tel/4601/final/final.tex

\documentclass{article}
\usepackage{../tex/mysty}
\begin{document}

\maketitlepage{Final Report}{Shuyen Liu}

\setcounter{tocdepth}{3}
\tableofcontents
\newpage

\section*{Executive summary}
\label{sec:exec-summary}

Modern research suggests that genetics is closely related to ophthalmological diseases such as 
myopia, a trend that can be studied by examining alterations in gross eye shape. Currently research is performed using mouse models which are easily available, genetically altered, and affordable. Due to the small size of mouse eyes, such research calls for high-resolution devices capable of measuring the dimensions of an object on a very small scale. This project proposes a 3D imaging device capable of 
measuring eye shape with micrometer precision. The target users of the device are primarily ophthalmological researchers studying genetics, but the application of the device may be extended to any field that requires 3D imaging of small object. 
The client of the project, Dr. John Nickerson of Emory University, requested that the final solution be able to produce a reconstructed 3D image of a mouse eye ball down to the resolution of 2 $\mu$m given a non-deformed eyeball with no concavities. The client also provided a Keyence LS-7030 LED digital micrometer as the  device’s core component. Device design centers on the provided micrometer, which utilizes parallel visible light beams in a concept  similar to early CT
designs. Thus, the design of the imaging device resembles that of earlier CTs. Theoretically, 
the device will rotate the object and measure each slice, and once finished will move to the 
next slice. The image will be reconstructed through back projection of the 
measurements of each slice and subsequent stacking of all the reconstructed slices. To achieve 
the tasks, the design solution uses motors to rotate the eyeball, which is fixed in a 
harness and polymer solution-filled tube, and to drive the micrometer, connected to a designed block, up and down shafts in order to create image slices. The solution also includes National Instruments LanVIEW software and hardware that control the device and perform image reconstruction of the eye.

Performance testing occurred throughout the process of prototype development to 
verify if each version of component satisfied certain criteria. Tests were done in a binary pass/fail fashion due to time constraints and divided into three categories: physical, electrical, and computer or programming. Initial prototype iterations had major failures related to misalignment of the physical components that resulted in skewed measurement data. The latest prototype did not fail any tests.

The envisioned final device will a structural framework similar to the prototype, but its mechanical and electrical components will be placed in a metal casing so that the user will be interacting with a black box and its controlling software rather than being exposed to several messy circuits. The eyeball will also be held in an optical tube, and an optical lens will be purchased to correct for the distorted measurement caused by the polymer fixate. Recommendations for design improvement include replacement of motors to those with encoders to increase accuracy, more precise manufacture of components to improve alignment, and a redesign of the optical lens/tube/polymer system to avoid bending the path of light from the micrometer. After implementing these suggestions, the final 
solution will fulfill the major requirement that 3D image resolution should be at micron 
level. 

\newpage

\section{Project Description}
\label{sec:project-description}

\subsection{background}
\label{sec:background}
Myopia is one of the most common ocular diseases in human, reaching approximately 25\% of most Western population and more than 80\% in some Asian populations.\cite{rajan98}1 Current research suggests that there is a strong genetic influence upon the development of the condition in addition to extrinsic factors.\cite{zhou99:genes,zhou99:models,schmucker04}2,3,4 As a result of such studies, many ophthalmology researchers have begun to focus on how specific genes affect the development and maintenance of the eye. Mouse has been commonly used as an animal model due to availability, ease of genetic manipulation, and affordability.\cite{schaeffel04}ref 8  However, because precise measurements of the eye dimensions are essential in determining the effect of genes and environmental factors on eye growth and disease, the small size of the mouse eye has been a critical impediment to research in this field.\cite{schaeffel04}ref5 
 
Using the mouse model, researchers need to be able to accurately measure the Anterior-Posterior axis of the small mouse eyeball, whose effective anatomical deformations occur at resolutions of 5 microns.\cite{schaeffel04}ref5  Current techniques for characterizing external eye shape (Table 1 of 4600 final) include manual contact (physical micrometry),\cite{wallman04} ref6 histological sectioning,\cite{schaeffel04}ref5 magnetic resonance imaging (MRI), computed tomography (CT) imaging, positron emission tomography (PET) imaging,\cite{atchison04}ref7 and optical interferometry.\cite{schaeffel04,guggenheim04}ref5,8 Each technique measures the eye but is either too difficult for common use or too inaccurate for precise use. Presently, no method exists for rapidly, easily, and accurately determining the gross exterior shape of the eye at a resolution under 5 μm within a laboratory setting. 

\subsection{Target Device}
\label{sec:target-device}
One current technique for determining eye shape involves manual measurement of the eye dimensions on the micrometer level using a high-precision, high-throughput industrial laser-emitting diode (LED) micrometer. \cite{Nickerson}ref9 (SIA) While other technical methods involve complex optical manipulations, automated measurement and manipulation of an LED micrometer could fill the oft-cited need for a lab bench-sized, automated digitizer which can handle small organic objects such as dissected mouse eyes.\cite{schaeffel04,atchison04,zhou99:genes,zhou99:models} ref8,1,2,3 of project update  The ideal design involves a high-precision articulation frame which locates and manipulates the
measurement plane of an attached micrometer in order to scan over the full geometry of the eye. Collected scanning data is then sent to a computer controller for decoding and used for construction of a digital, three-dimensional (3D) model of the scanned object. Such a device could quickly, precisely, and repeatedly provide the full gross geometric shape of a dissected eye and also provide for software to statistically analyze trends in shape over populations and experimental treatments.

The team has proposed a device which implements complete 3D reconstruction of the eye by scanning over the eye with a laser-emitting diode (LED) micrometer. The device, pictured in FIGUREONE(SIA), consists roughly of three parts including an eye-actuating harness, the micrometer frame, and
the computer interface. The eye harness holds the eye and fixes it rigidly for acceleration without impacting the optical path for the micrometer. It consists of a pair of reverse-action tweezers which are fitted into a cylindrical cuvette filled with a high-viscosity polydimethylsiloxane (PDMS) buffer suspension. When the cuvette is inserted into the frame of the device, it is placed against a corrective lens which corrects for the optical distortion from the cylinder (not shown). The harness then attaches to a motor supplemented by an angular encoder, which can then accelerate the tube while simultaneously keeping high-resolution data on its current theta-position (PICTURES/ADDENDUMS/LABELING OF PARTS?).

The micrometer frame holds the motors and the micrometer heads, which consist of the receiver and transmitter. The heads are attached to a syringe pump frame augmented with another motor/encoder pair to provide linear articulation in the z-direction while maintaining high-resolution position data. Finally, the data from the two encoders and the micrometer is fed into a National Instruments Single-board Reconfigurable Input Output device (sbRIO), which provides real-time feedback and control while collecting data for online reconstruction (PICTURES/ADDENDUMS??). The reconstruction algorithm itself is a modified back-projection algorithm supplemented by cosine interpolation in the z-direction (PICTURES/ADDENDUMS).

\subsection{Target Users and Societal Impact}
\label{sec:users}
The target users of the device will be researchers in ophthalmology, particularly those who conduct studies requiring precise measurements of an eye. An estimated number of 500 researchers working at 70 medical research institutions will benefit from the device\cite{Nickerson}ref9 (SIA), which  will enable researchers to conduct current research easier and faster and introduce new avenues such as scanning techniques through which to study the eye. The improved performance supplied by the device would translate into savings, in terms of both time and money, for both researchers and organizations
that fund them, such as the National Institutes of Health (NIH). This in turn would allow money from the
general public and resources at research institutions to be invested in making discoveries on more fronts,
advancing scientific knowledge at a greater rate. %apparently we want to quantify this last bit how does this make sense?

\section{Engineering Design Specifications (EDS)}
\label{sec:engin-design-spec}
A complete list of engineering design specifications is shown in Table ONE \ref{tab:eds}.

\subsection{Functional and Customer Requirements}
\label:{sec:func-cust-req}
The customer requirements can be split into three categories: needs, wants, and desires. ``Needs'' are the functional requirements and constitute essential aspects of the device required for proper use, while ``wants'' are non‐essential aspects of the device that would facilitate proper use. ``Desires'' are aspects of the device which, if satisfied, would please the customer beyond proper functioning.  

The most significant feature needed by the device is the ability to take automated measurements of ocular dimensions with a resolution of 0.5 diopters, equivalent to a resolution of 2 $\mu$m for mouse eyes. The critical active sensing components of the device need to have a resolution below 2 $\mu$m in order to ensure precise
measurements at a resolution of 2 $\mu$m. The device also needs to be
able to convert raw measurements into a 3D interactive reconstruction
of the eyeball on a computer interface. The client initially requested that
the device be able to take a complete set of measurements in
under 3 minutes in order to prevent the eye from drying out and
distorting the results, but given the addition of a polymer fixate to the design, the time requirement was dropped. Also, the device needs to be able to fit onto
a typical laboratory bench, into a space of 1m $\times$ 1m $\times$
1m, but does not need to maintain a sterile field.

One ``want'' of the client is that the device has mobility; that is,
it can be lifted and carried from one lab bench to another by an
average healthy researcher from age 20‐50. Therefore, the device
should be lightweight; the weight of the device should not exceed 40
lbs (18 kg).\cite{gross03} To fulfill the mobility want, the size of
the device must also be small. The device must
be able to fit on a typical laboratory bench, in a space of 1m $\times$ 1m $\times$ 1m. The device should also not be cumbersome; the design of the device should be
simple and manageable with few external components.

The customer also wants the device to have a simple user interface with which measurements taken by the device may be transferred onto a connected computer with just 1 click of the mouse. The device should  be reusable for up to 4 years given constant daily use of the device at least 5 times a day, with 1 hour per use.\cite{keyence01} The device should not require any maintenance unless one of the components stops functioning.\cite{keyence01} In addition, the device should cause little to no vibration during operation such that the accuracy of measurements is unaffected. 

Finally, the client desires that the device be aesthetically pleasing, and not make much noise during operation. The noise produced by the device should not exceed the level of 80 dB, the loudness of the average car.\cite{truax09}

\subsection{Engineering Characteristics}
\label{sec:eng-char}
The device needs to be robust enough to withstand the stresses of
everyday lab use. Robustness is defined as the ability to withstand
rough accidental movement such as being dropped from the top of a lab
bench, typically at a height of 3 feet, or shoved sideways on the
bench surface. The device should also be able to hold the weight of
small objects no heavier than 5 pounds, such as lab notebooks, pens,
or a rack of test tubes. The device needs to be able to function in
the wide range of temperatures typically found in the laboratory (22±5
$^\circ$C) and, as mentioned previously, it needs to be able to fit comfortably onto a lab bench withina space of 1m $\times$ 1m $\times$ 1m. The non‐electrical components
of the device should be inert and should not be affected by small
quantities (less than 1 mL) of minimally hazardous solutions such as
PBS,\cite{users_manual} which is typically used to keep the eye
moist. Electrically, the device needs to function with 120V 60Hz AC,
the standard power supply of the United States.

\section{Prototype Development Discussion}
\label{sec:prot-devel-disc}
 
The device design consisted of four main aspects. The frame, eye harness, electrical components, and computer interface were all developed separately. Each aspect of the device underwent several iterations. A prototype development timeline can be seen in TABLETWO-TO-BE-UPLOADED.

\subsection{Introduction}
\label{sec:prior-art}
	The central component of the device is the Keyence LS-7030 LED digital micrometer provided by 
the client. The LED micrometer assumes that light travels between the emitter and receiver in an 
undistorted fashion, and that only the measured object occludes some of the light incident upon the 
receiver, as reviewed in US patent No.6,947,152, High Speed Laser Micrometer.  A prior art and literature search found that among the current techniques, x-ray computed tomography is most relevant to the design solution of the current opportunity because its core measuring component is similar to the LS-7030 micrometer in concept. The principal steps in computed tomography 
include measuring attenuation at different angles, reconstructing a slice via back-projection, and repeat the step for next slice. The design solution was based on this process, which requires angular (theta) and 
translational (z) motion and image reconstruction. 

\subsection{Design Components}
\label{sec:prototype-comp}
	The design solution prototype employs two motors for angular and translational motion. The initial design focused on resolution of the resulting image and intended to move the micrometer both translationally and angularly. However, the team found that this design was hampered by a significant moment of inertia due to the weight of the micrometer. In addition, the client raised concerns about damaging the micrometer, the core piece of the device. 

Given these concerns, the team re-designed the device to rotate the target of interest (the mouse eyeball) and, at the same time, move the micrometer translationally. In accordance with these goals and the requirements of the EDS (TABLE ONE), the initial design solution consisted of the following components: 

\begin{enumerate}
 \item an optical tube with polymer fixate that suspends the mouse eyeball and helps it maintain its overall shape; 
\item a harness that holds that prevents the tube from moving translationally as it is being rotated and holds the tweezers that suspend the eyeball in the center of the tube;
\item motors for rotational (theta) and translational (z-axis) motion; 
\item connecting shafts between the rotational (theta) motor and the cylindrical tube and between the translational (z-axis) motor and the micrometer;
\item a structural framework to ensure physical alignment between components; 
\item encoders, in conjunction with a National Instruments sbRIO board, which manipulate the motors and transfer data between the motors to the computer;  
\item an image reconstruction algorithm created in the LabVIEW Development System;
\item and a user-centered computer interface. 
\end{enumerate}

\subsection{Harness and Fixate}
\label{sec:harness}
	The interior piece of the device consists of an optical tube bookended by two caps on the top and bottom (SOME KIND OF PICTURE REFERENCE SHUYEN’S SOLIDWORKS YAY).  The top cap has a slit through which tweezers will be placed in order to suspend the eyeball by the optic nerve, while the bottom cap is connected to the theta (rotational) motor through a shaft. The bottom cap is detachable from the theta-motor shaft so that the tube can be removed from the device and be loaded with a new eyeball. A polymer fixate inside the tube allows the eyeball to maintain its gross shape.  All of the core pieces are cylindrical and have their centers on the axis of rotation. An optical lens outside of the tube will correct the path of light from the micrometer that is distorted by the tube and fixate solution.
	
The development of the eye harness and its associated components can be seen in TABLE TWO TO BE UPLOADED. Initially, the eyeball was placed in a standard test tube and a 10\% methyl cellulose solution. However, the distortion of light caused by methyl cellulose was too great, and so the polymer fixate was switched to a 10:0.2 ratio of PDMS base and curing agent due to the optical and viscous properties of PDMS . The team then found that the optimal viscosity for the fixate was a 10:0.3 ratio of PDMS base and curing agent, and so used that solution as the final fixate. Finally, a custom-made cuvette was made in order for the tube to fit more neatly into the harness. The cuvette, however, was not made of optical glass, and an optical lens to correct for the distortion of the tube and polymer was never purchased due to temporal and financial constraints. 
	
The eye harness, tweezers, and connector pieces also each underwent several iterations (TABLE TWO TO BE UPLOADED). The harness and tweezers initially started off as big, bulky pieces whose size was narrowed down over the course of development. (REF, FIGURES HERE?)

\subsection{Framework}
\label{sec:frame}
	The device contains a structural framework that allows the axis of rotation of the theta motor, the eyeball, and the structures that support the eyeball to be along the same axis. The micrometer heads are attached by their base to a block whose position is guided and driven by the translational or z-motor through threaded shafts. The position of the micrometer is controlled in such a way that the plane of measurement is perpendicular to the axis of rotation (REF: PICS AND/OR SOLIDWORKS DRAWINGS). A computer connects to the motors to control them and reads data from the micrometer for image 
reconstruction. 
To achieve good alignment, the design solution uses custom-made pieces to hold components in place. A flat metal board is used as a base on which the mechanical components sit. A frame, consisting of a top, a bottom, and two legs that connect and support the top piece to the bottom piece, attaches to the heavy metal base with bolts and nuts. The theta-motor is press-fitted to sit in a designed cavity and defines the axis of rotation. The top piece has a hole that is concentric to the axis of rotation and serves to maintain alignment of the eye harness, eyeball, and fixate tube. 
	Like the eye harness, the framework narrowed in size with each iteration. Additionally, the framework parts and other custom-made pieces were initially constructed using a  Zprinter® 310 (inkjet) Printer with special starch powder, but were later printed using the Stratasys(Registered) Dimension 1200 FDM (Fused deposition modeling) Printer with ABS (acrylonitrile butadiene styrene) material. 

\subsection{Notable Iterations}
\label{sec:iterations}

The first draft of the prototype’s structural framework from the Zprinter showed that the structure was sturdy enough to not vibrate excessively when connected to the motor. However, since the Zprinter does not have good enough resolution for tight connections and precise positioning of parts, the FDM Printer was chosen to print the structures for later iterations. The second draft of the framework used the same blueprint as the initial draft but was printed with the FDM printer, resulting in a framework that is lighter, more precise, and allowed better fitting between parts. Like the z-printed model, it is also strong and does not vibrate much. 
	The first z-motor was was 0.6 amperes mounted on a modified microscope stage. It did not have enough power to drive the micrometer and was switched with a 2 ampere stepper motor on syringe pump.

\subsection{Electronics and Programming}
\label{sec:electronics}

The National Instruments sbRIO board, which runs using LabVIEW Real-Time and LabVIEW FPGA software on the computer, links the computer and the hardware and is used as a controller for the entire device (PIC#). The board collects all measurement data at an appropriate rate, and also inputs commands to both the rotational and translational motor, providing the user with real-time, deterministic control over the device. The protoboard (PIC#) converts inputs from the sbRIO board into outputs that drive the motors, while the host computer provides a user interface for control of the device in addition to logging trinary measurement data (from the z-axis, theta axis, and micrometer) and performing image reconstruction using such data. 

The team initially faced difficulty in recording binary code decimal (BCD) digits, the form of data given by the micrometer, and in collecting the data from the motors and micrometer in a real-time, simultaneous fashion required for accurate reconstruction. However, with each iteration (and each successive experiment with the LabVIEW software), the team became more familiar with the software and gradually de-bugged and polished the code to solve these problems. 

	Image reconstruction was performed using an online freeware program called MeshLab. \citeMESHLAB_CREATE CITATION, which used a combination of Poisson reconstruction and Ball-pivoting surface reconstruction to perform 3D reconstruction on the acquired data. 

The current version of the prototype can be seen in FIGURES  TWO THREE FOUR FIVE SIX (Joe’s pics from today, numbered and labeled with all parts)

\section{Performance Testing and Results}
\label{sec:perf-test-results}

Performance testing took place for each aspect of the device after every iteration and revision. Due to time constraints, all of the testing was done in a binary (pass/fail) fashion to see if the component met certain minimal requirements. The tests were broken down according to three major subsystems: physical/mechanical components, electrical components, and computer control tests. Under each system there were sub-subsystem such as the frame and eye harness for mechanical tests and the motors for the electrical tests. The testing hierarchy and details are listed in the TableTHREE (tests.csv). Tests were done on a case-by-case basis and did not correlate to those listed in the verification protocol since they required revision after each design iteration. 
	
Tables FOURFIVEANDSIX (tests-c.pdf, tests-e.pdf, and tests-p.pdf) contain the test results, showing whether each revision (as referenced in the TABLE TWO) achieved a certain requirement. Major physical failures generally pertained to the rotational theta motor and eye harness; an angle exists between the axis of rotation and the axis of the eye harness tube, causing the eyeball to shift in space and resulting in poor accuracy and precision for collected data and reconstruction. Other failures like the inability of the theta motor to resist heating and possible eye shape distortion over a two-hour time span set an upper limit for the data acquisition time. Electrically, the only significant failure was the inability to record binary code decimal (BCD) digits from the micrometer. Since BCDs are the form of data given by the micrometer, this failure initially limited the method applicable for image reconstruction. 

	For the computer  control aspect of testing, most of the failure occurred on the software side. The software was not able to control the motors and collect data in a real-time fashion. In addition, as the software controlled and recorded data, there were small time-delays between recordings of theta position, z position, and the length information from the micrometer.  This problem was solved during further design iterations that polished and optimized the code in the LabVIEW software. 

\section{Final Design Solution}
\label{sec:final-design-solut}

The final device will have a structural framework similar to the one found in the most recent prototype; this framework design is stable and strong enough to sustain moderate weight. The electronics will be compressed into printed circuit board, or PCB, to reduce volume, since the current prototyped bread board circuit is messy and not spatially efficient. The physical set-up of the device is demonstrated in Fig##(final schematic.jpg) .

The prototype, as seen in FIGURE-PIC, currently has all of its components exposed, leading to a risk of misalignment or other accidents like liquid reagent spills in the laboratory that affect device function.  For the final design solution, all of these components will be placed inside a metal enclosure designed to be the smallest size possible. The top of the structural framework with the tweezers slit will be at exposed to the outside environment through a small opening at the top of the enclosure, allowing the user to assemble the eye harness with inverted tweezers, an eyeball, and a tube of polymer fixate and insert it into the device. The PCBs will be attached to the bottom of the case - a role currently served in the prototype by the heavy metal base board (FIG SOLIDWORKS topdown_frame) -  and all wiring and connections will run along the wall of the case to a connection window that opens to the outside. The edges of the case will be rounded for safety considerations and made out of aluminum sheet of at least 0.1 inch thickness, ensuring that it is strong enough to sustain 40lbs of weight. Rubber feet will on the bottom corners of the box in order to prevent the box from sliding off of a table or damaging the surface on which it is placed. The case will also have ergonomic, padded handles with rubber grips to facilitate lifting and transportation of the case.  

The z-actuator (REF FIGURE final_schematic) will consist of the guiding rails, driving shaft, and the z-motor. The rails and shaft will essentially be the same as the ones used in the current prototype. However, a more highly powered z-motor with an attached encoder will replace the motor currently in use so that the micrometer will experience less vibration and the z-position can be more accurately determined. The theta motor will also be replaced for better driving power, accuracy and heat resistivity. Heat resistivity is of interest because thermal expansion can mess up the alignment and perhaps melt any plastic piece in immediate contact with the motor.

The eye harness pieces will also retain similar profiles to those of the prototype, consisting of a top and bottom cap, a polymer fixate solution within an optical tube, and inverted tweezers.  The final device will also contain an optical correction lens to account for the distortion of the polymer solution and the tube. The top cap of the harness will be designed to have a ratchet button attached to a pair of reverse tweezers whose tip opens up when the button is pressed, allowing the eyeball to be loaded more easily into the device. The harness requires high accuracy production so that all of its optical properties are correct and all of the components are accurately aligned. The fixate solution will also be custom manufactured so that its optical properties match the corrective lens.

The software and hardware of the final device will have the same functions as in the prototype. They will control the motors, gather data from the micrometer and motors, and reconstruct a 3D image using the collected data. 

The motors will drive the eyeball and the micrometer in the following fashion as seen in FIGURE SOMETHING. The theta-motor initializes and drives the eyeball at constant speed, and after each 
full rotation, the z-motor drives the micrometer to the next z-position for acquisition of a new image slice. These two steps repeat until the whole eyeball is scanned. The stopping condition will be two thresholds outside of data is no longer collected from the eyeball. The micrometer reading speed is set to ???, the theta motor speed is set to ???.

The user interface, currently not designed, will consist of a graphical user interface with buttons for starting the scan, emergency stop, image reconstruction and display and other minor functions. 

\section{Discussion, Conclusion, and Recommendations}
\label{sec:concl-recomm}

The final prototype meets some of the requirements of the EDS (TABLE ONE). It can acquire the desired measurement data and perform 3D reconstruction using such data, therefore it fulfills its main functionality. It is able to move both the object and the micrometer, and its structural framework is sturdy enough to produce little vibration.  It is also able to fit onto a typical laboratory counter in space of 1m $\times$ 1m $\times$\1m and functions under the standard United States electrical power supply of 120V 60Hz AC. The loudness of the device does not exceed 80 dB, and the computer user interface actually exceeds the user’s expectations; all of the measurements by the device are automatically transferred to the computer, and no action by the user is required beyond clicking a start button to begin the measurements. 

However, the prototype still needs much more improvement and testing in order to meet its other specifications. The measurements taken by the device are of unknown resolution, and the device cannot easily be lifted by one person due to the exposed circuitry of the hardware and the heavy metal base board of the framework.  It cannot be considered robust because one could easily brush up against the device and cause misalignment of the exposed interior frame pieces or circuits and skew the accuracy of the measurements. Moreover, the effect of common laboratory reagents such as PBS upon the device components has not been tested. 

 The envisioned final design utilizes the high through put of the micrometer. As show in the calculation in Appendix??, the z-motor speed and theta motor speed (5 RPM) should theoretically yield a resolution of ?????,  satisfying the main requirement of good resolution image. At that speed, the eyeball can also be scanned within ????(time). Although speed is not a requirement, it is desirable because it saves time. The sturdy structural frame, reinforced by the metal casing, will satisfy the stability requirement which also affects the accuracy of the measurement. The software will be able to make 3D rendering as requested by the client, and the small size and simplicity of the device, being essentially a black box with its controller, satisfies the requirement of mobility. However, the user interface of the final design solution will increase in complexity by providing more options on its graphical interface.  

Recommendations for improvement can be seen in TABLE SOMETHING. 

\newpage
\addcontentsline{toc}{section}{References}
\bibliographystyle{unsrt}
\bibliography{../tex/bibl}

\end{document}
%%% Local Variables: 
%%% mode: latex
%%% TeX-master: t
%%% End:
