tel/4601/regulatory/pages/indications.tex

\newpage
\addcontentsline{toc}{subsection}{Indications for Use Statement}
\singlespacing
\begin{center}
  \large{Indications for Use Statement}
\end{center}

\onehalfspacing

\noindent 510(k) Number (if known): N/A \\
Device Name: \textbf{eyeScan Mezzo} \\
Indications for Use: \\

The \textbf{eyeScan Mezzo} is intended to accurately capture and
reconstruct the three dimensional surface of dissected mouse
eyeballs. The device is meant for use in ophthalmological research
settings, and not for clinical applications. The results from this
device are not intended to directly diagnose or cure live animals or
humans. The device is incapable of detecting concavities, meaning
eyeballs to be measured should not contain concavities of interest.

The device is designed to handle eyeballs by the optic nerve, meaning
the dissection should be performed so as to preserve the joint between
the eye and the optic nerve. The solution in which the object to be
measured is set has been designed specifically for use with
mouse eyeballs. Other tissue material may not be of an equivalent
tonicity, which may lead to error in measurment. The \textbf{eyeScan
  Mezzo} is to be used only by lab technologists trained in laboratory
techniques, procedures, and on use of the device.

\vfill

\noindent \textbf{Over-the-Counter Use XXX} \\
(21 CFR 801 Subpart C)\\[1em]

\noindent (PLEASE DO NOT WRITE BELOW THIS LINE-CONTINUE ON ANOTHER PAGE IF
NEEDED)

\rule{\linewidth}{0.5mm}
\begin{center}
  Concurrence of CDRH, Office of Device Evaluation (ODE)
\end{center}

\vspace{5em}

\newpage
\singlespacing
\addcontentsline{toc}{subsection}{Endications for Use Statement --- Substantial Equivalents}
\begin{center}
  \large{Indications for Use Statement --- Substantial Equivalents}
\end{center}

\onehalfspacing

This device is similar to microscopes and micrometers in its intended
use due to the following:
\begin{itemize}
\item The device is intended to measure an object.
\item The device is intended for use on extracted tissue samples. \\
\end{itemize}

This device is similar to optical coherence tomography in its intended
use due to the following:
\begin{itemize}
\item The device is intended to measure eyeballs, which constitute as
  an ocular structure. \\
\end{itemize}

This device is similar to computed x-ray tomography in its intended use
due to the following:
\begin{itemize}
\item The device is intended to make cross sections of an object of
  interest by varying the angle of measurement perpendicular to a
  fixed axis. This generates cross sections parametrized in
  cylindrical coordinates.
\item The device is intended to create reconstructions using the cross
  sections which involve a form of back-projection. 
\end{itemize}

\vfill

\noindent \textbf{Over-the-Counter Use XXX} \\
(21 CFR 801 Subpart C)\\[1em]

\noindent (PLEASE DO NOT WRITE BELOW THIS LINE-CONTINUE ON ANOTHER PAGE IF
NEEDED)

\rule{\linewidth}{0.5mm}
\begin{center}
  Concurrence of CDRH, Office of Device Evaluation (ODE)
\end{center}

\vspace{5em}

%%% Local Variables: 
%%% mode: latex
%%% TeX-master: "../reg"
%%% End:
