tel/4601/regulatory/pages/sterile.tex

\newpage
\subsection{Sterilization and Shelf Life}

This device is not sold as sterile. During operation, sterility
does not impact the safety of effectiveness of the device.
