tel/4601/regulatory/pages/statement.tex

\newpage
\addcontentsline{toc}{subsection}{510(k) Statement}
\singlespacing
\begin{center}
  \large{510(k) Statement}
\end{center}

\onehalfspacing

I certify that, in my capacity as a product development scientist, I
will make available all information included in this premarket
notification on safety and effectiveness within 30 days of request by
any person, if the device described in the premarket notification
submission is determined to be substantially equivalent. The
information I agree to make available will be a duplicate of the
premarket notification submission, including any adverse safety and
effectiveness information, but excluding all patient identifiers, and
trade secret and confidential commercial information, as defined in 21
CFR 20.61.

\begin{figure}[H]
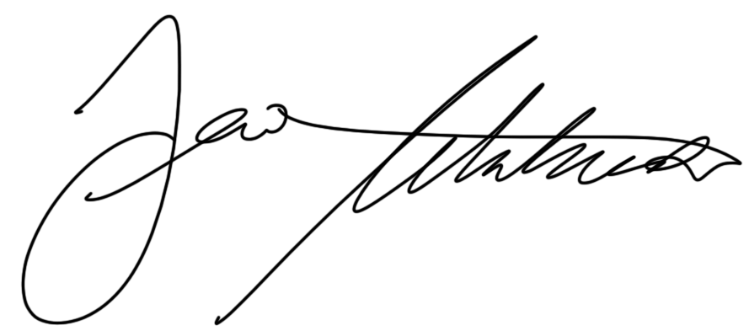
[picture p4: regulatory/imgs/ja-sig.png]
  
\end{figure}

\noindent Joseph Abrahamson \\
\today

%%% Local Variables: 
%%% mode: latex
%%% TeX-master: "../reg"
%%% End:
