tel/4601/regulatory/pages/truthbomb.tex

\newpage
\addcontentsline{toc}{subsection}{Truthful And Accurate Statement}
\singlespacing
\begin{center}
  \large{Truthful And Accurate Statement}
\end{center}

\onehalfspacing

I certify that, in my capacity as product development scientist, I
believe to the best of my knowledge, that all data and information
submitted in the premarket notification are truthful and accurate, and
that no material fact has been omitted.

\begin{figure}[H]
  
\end{figure}

\noindent Joseph Abrahamson \\
\today

%%% Local Variables: 
%%% mode: latex
%%% TeX-master: "../reg"
%%% End:
