tel/4601/regulatory/pages/certification.tex

\newpage
\addcontentsline{toc}{subsection}{Class I Summary and Certification}
\singlespacing
\begin{center}
  \large{Class I Summary and Certification}
\end{center}

\onehalfspacing

I certify that, in my capacity as product development scientist that
this device best claims substantial equivalence to a Class I device.

\begin{figure}[H]
  
\end{figure}

\noindent Joseph Abrahamson \\
\today

%%% Local Variables: 
%%% mode: latex
%%% TeX-master: "../reg"
%%% End:
