tel/4601/regulatory/pages/cdrh-cover.tex

\addcontentsline{toc}{subsection}{CDRH Premarket Review Submission Cover Sheet}

\begin{figure}[H]
  \centering
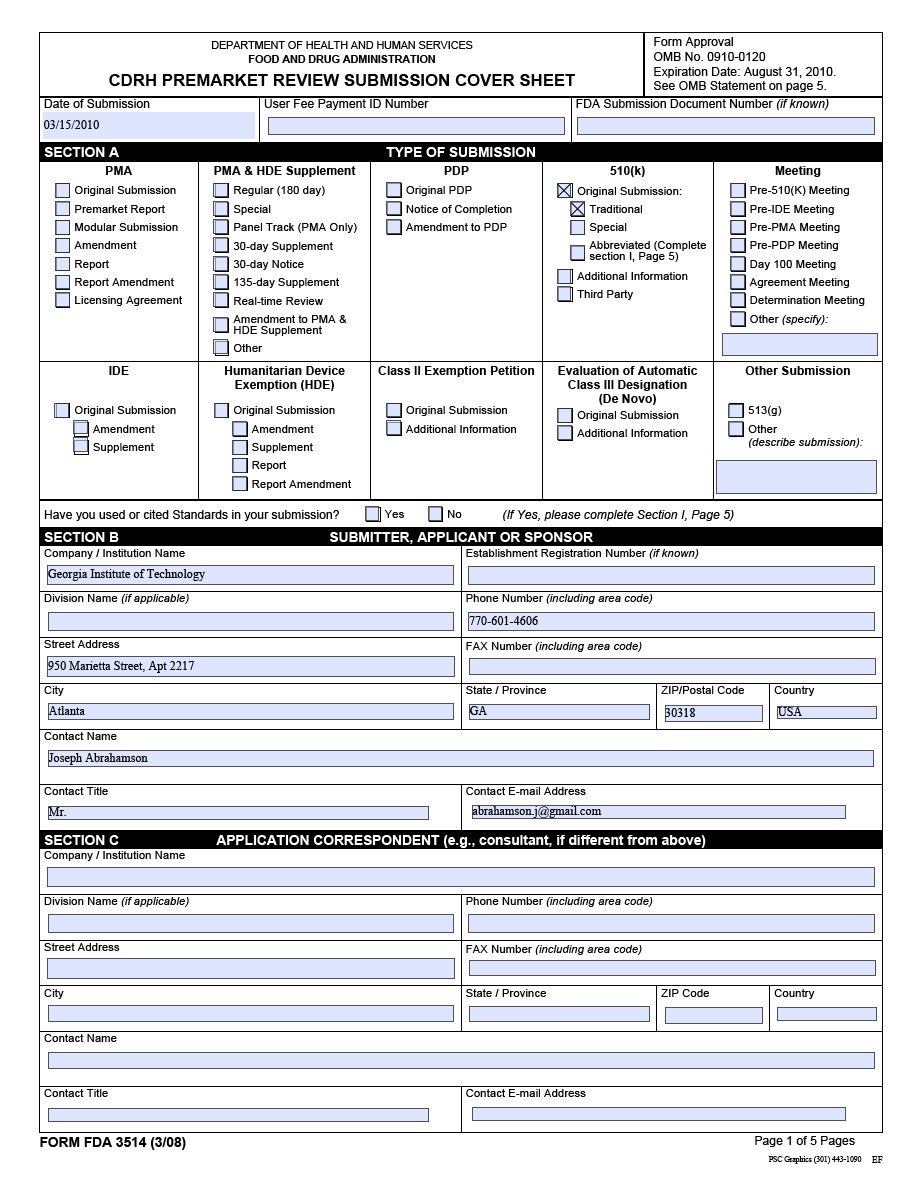
[picture p5: regulatory/pages/cdrh-pics/1.png]
  
  \label{fig:summary}
\end{figure}

\begin{figure}[H]
  \centering
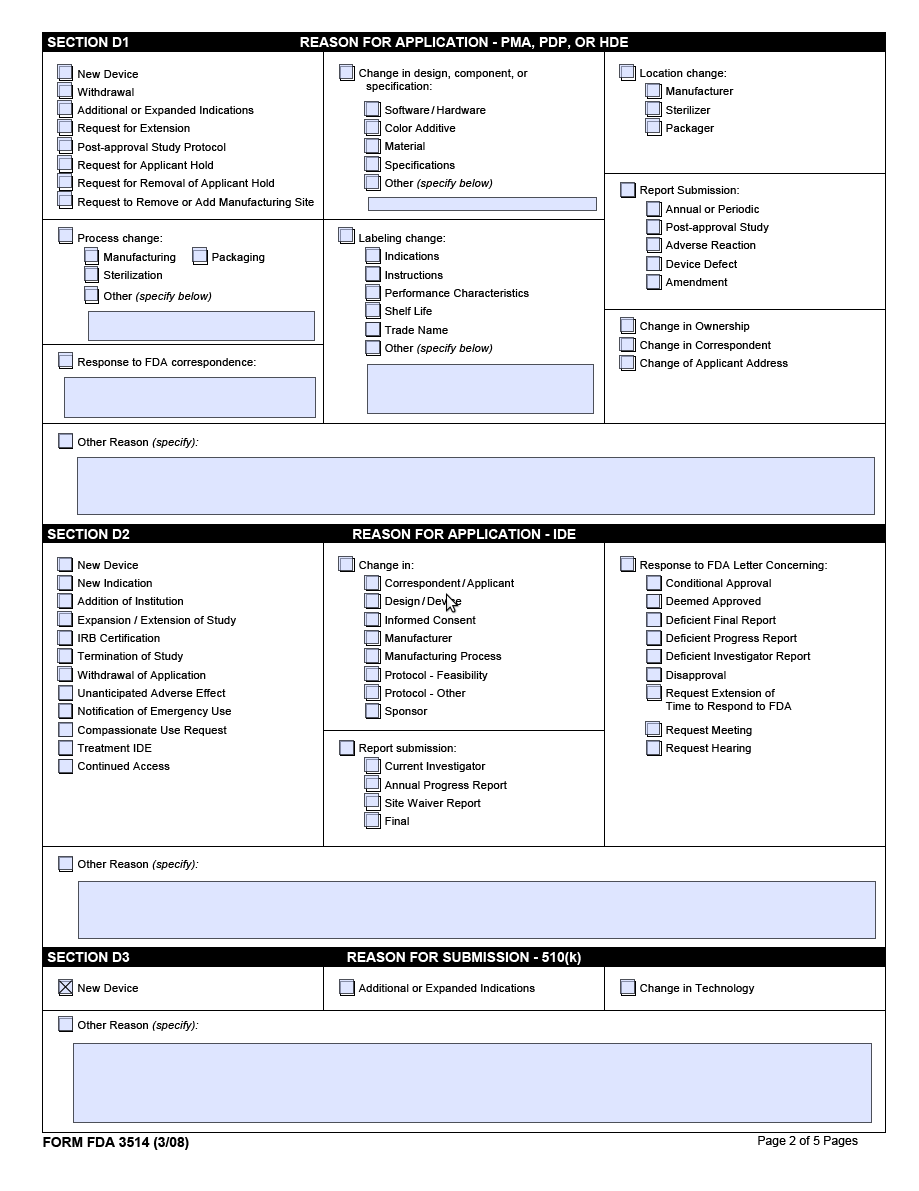
[picture p6: regulatory/pages/cdrh-pics/2.png]
  
  \label{fig:summary}
\end{figure}

\begin{figure}[H]
  \centering
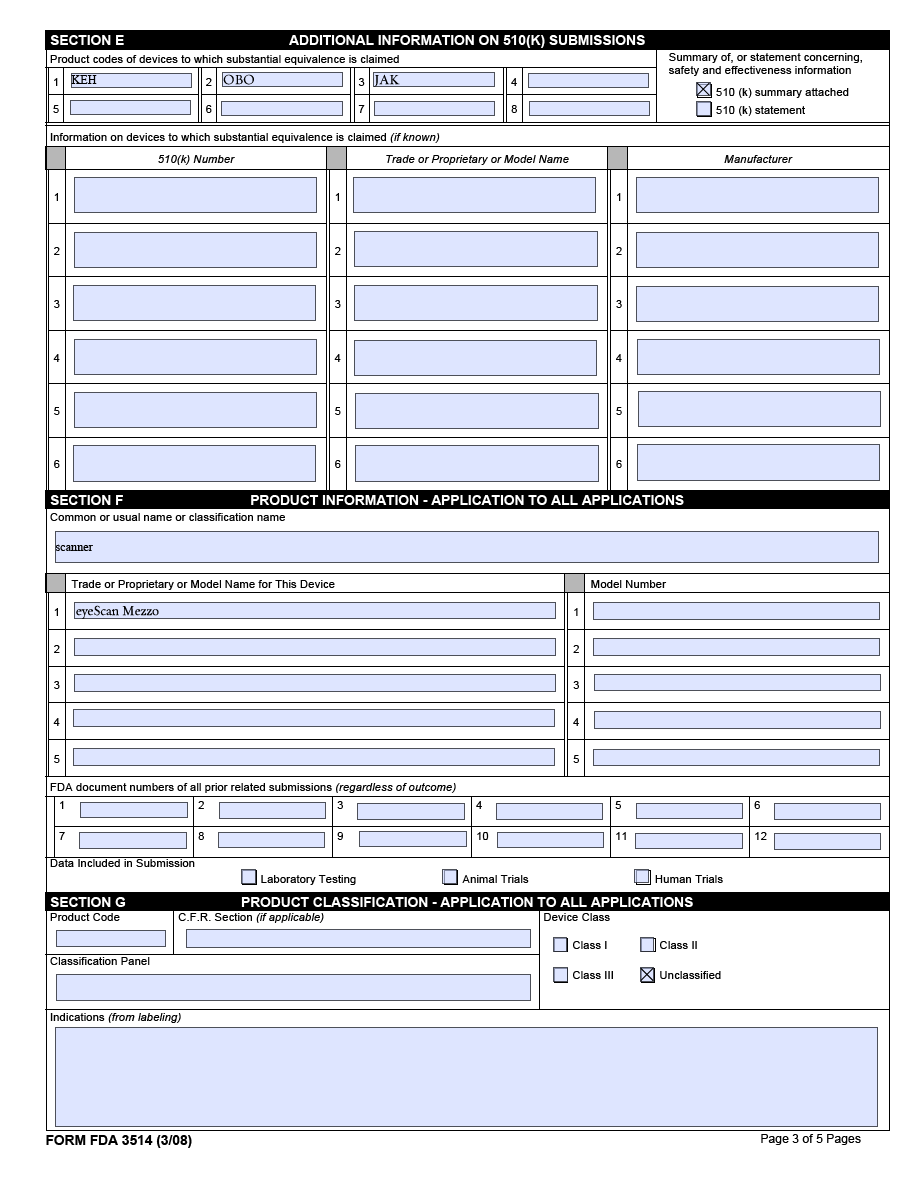
[picture p7: regulatory/pages/cdrh-pics/3.png]
  
  \label{fig:summary}
\end{figure}

\begin{figure}[H]
  \centering
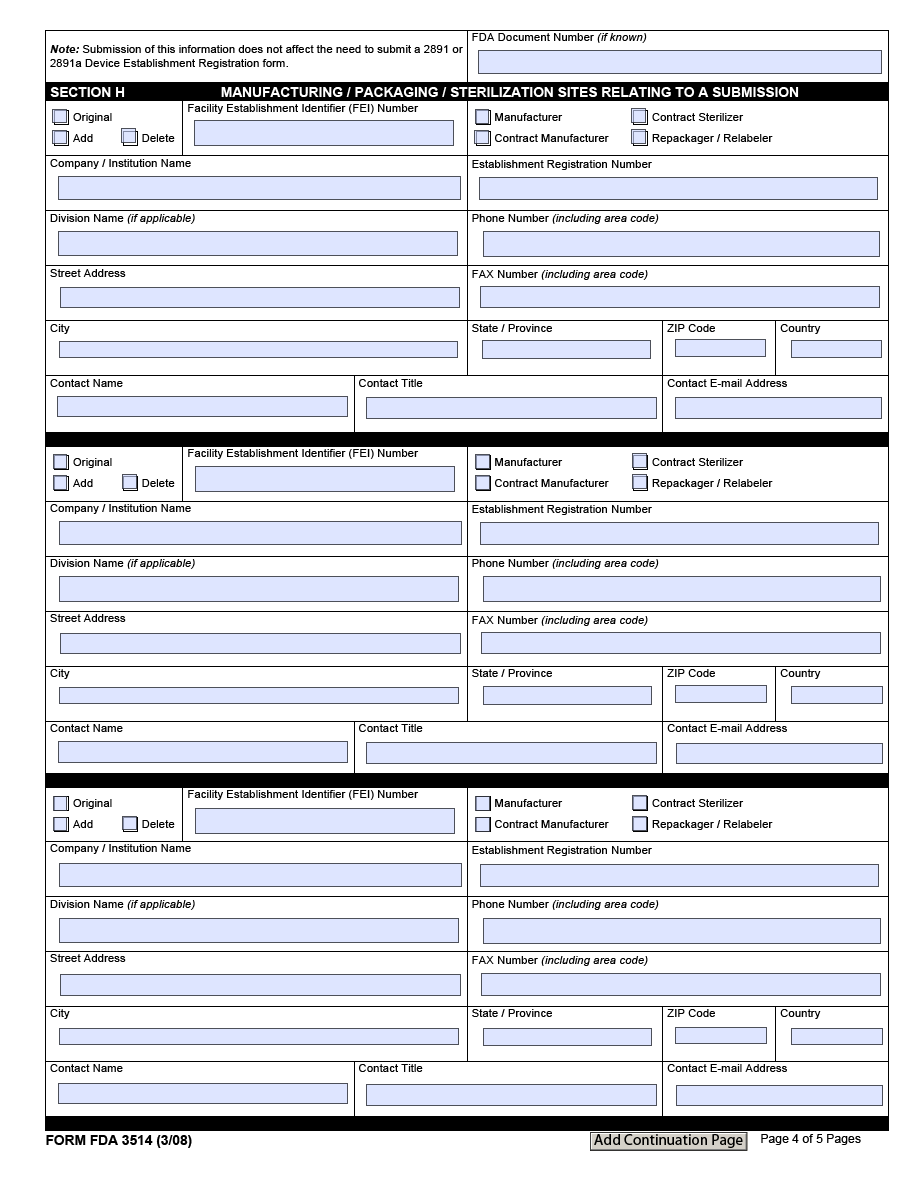
[picture p8: regulatory/pages/cdrh-pics/4.png]
  
  \label{fig:summary}
\end{figure}

\begin{figure}[H]
  \centering
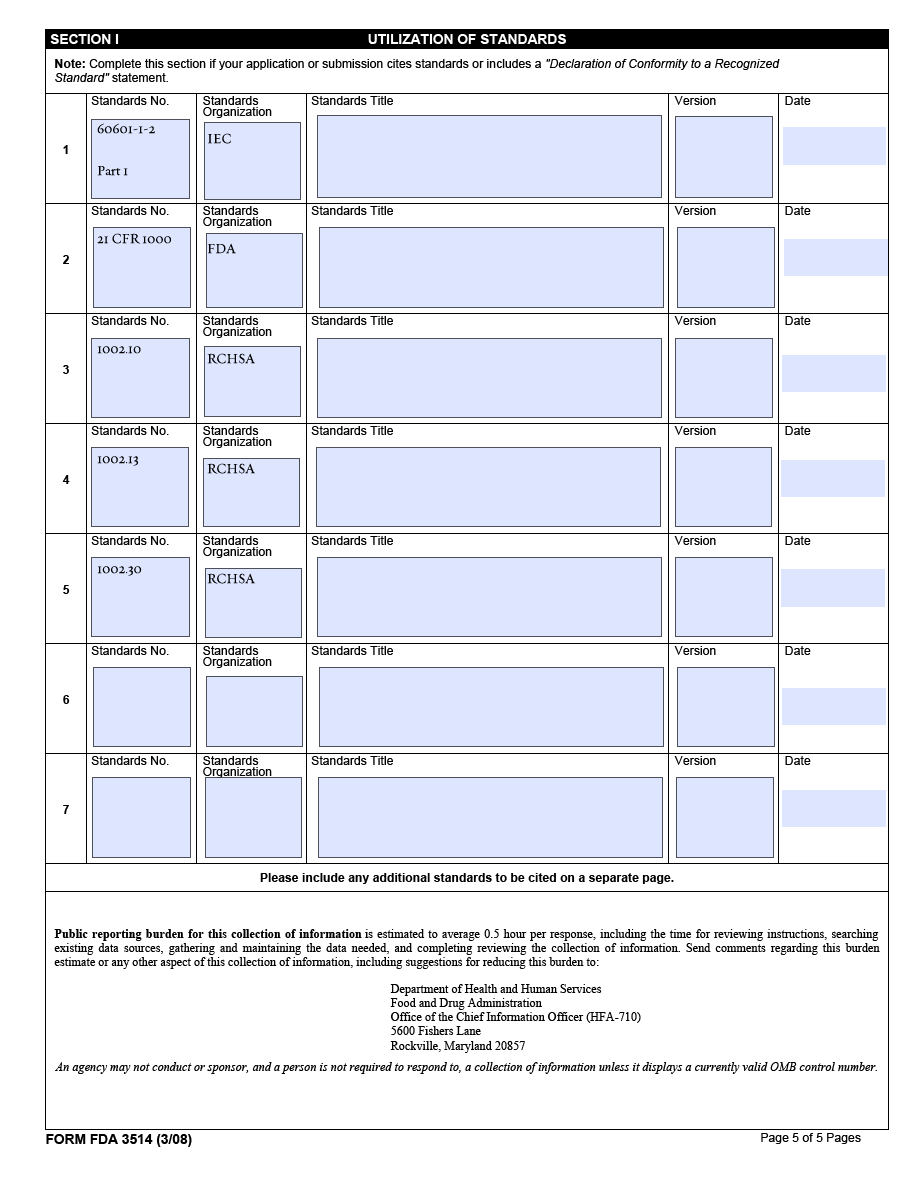
[picture p9: regulatory/pages/cdrh-pics/5.png]
  
  \label{fig:summary}
\end{figure}

%%% Local Variables: 
%%% mode: latex
%%% TeX-master: "../reg"
%%% End:
