tel/4601/regulatory/pages/financial.tex

\newpage
\addcontentsline{toc}{subsection}{Financial Certification or Disclosure Statement}
\singlespacing
\begin{center}
  \large{Financial Certification or Disclosure Statement}
\end{center}

\onehalfspacing

I certify that, in my capacity as product development scientist that
no clinical studies were performed and thus no financial disclosure is
possible or required.

\begin{figure}[H]
  
\end{figure}

\noindent Joseph Abrahamson \\
\today

%%% Local Variables: 
%%% mode: latex
%%% TeX-master: "../reg"
%%% End:
