tel/4601/img/shuyen/final schematic.JPG

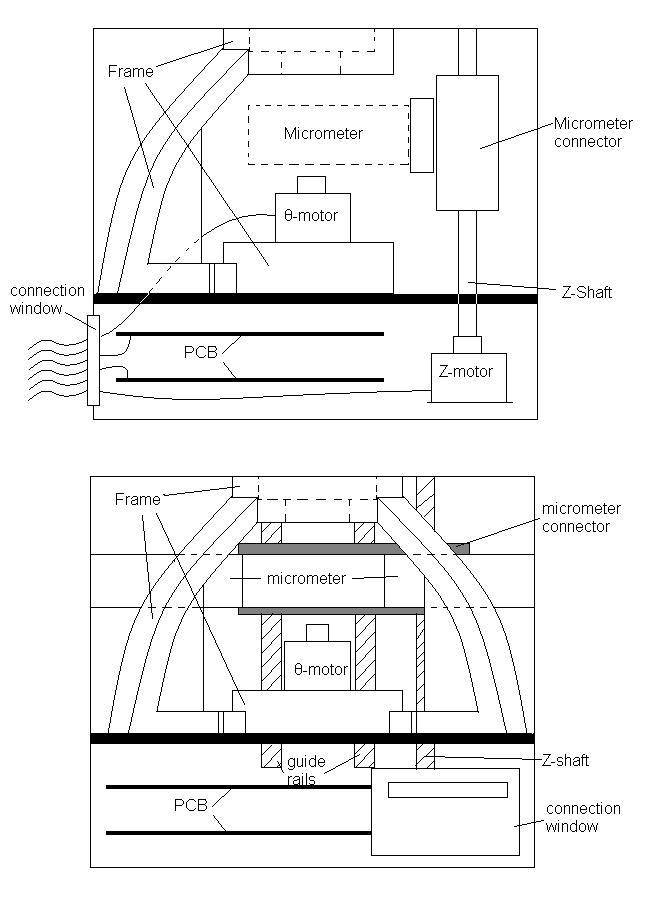
img/shuyen/final schematic.JPG
