tel/4601/img/shuyen/ver1/bottom frame.JPG

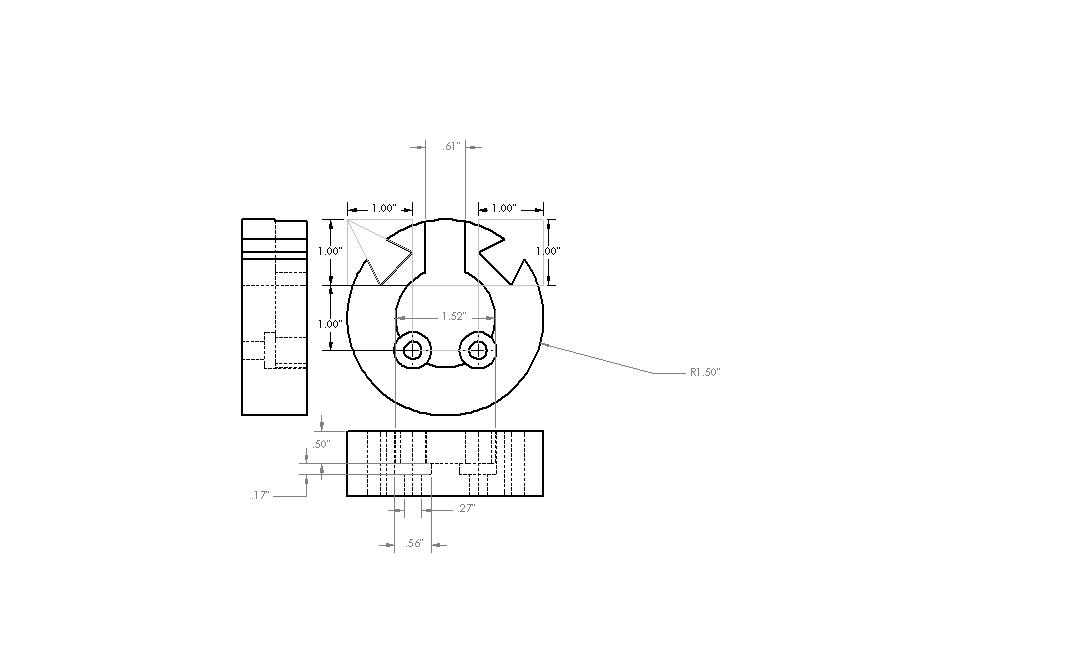
img/shuyen/ver1/bottom frame.JPG
