tel/4601/img/shuyen/ver1/support leg.JPG

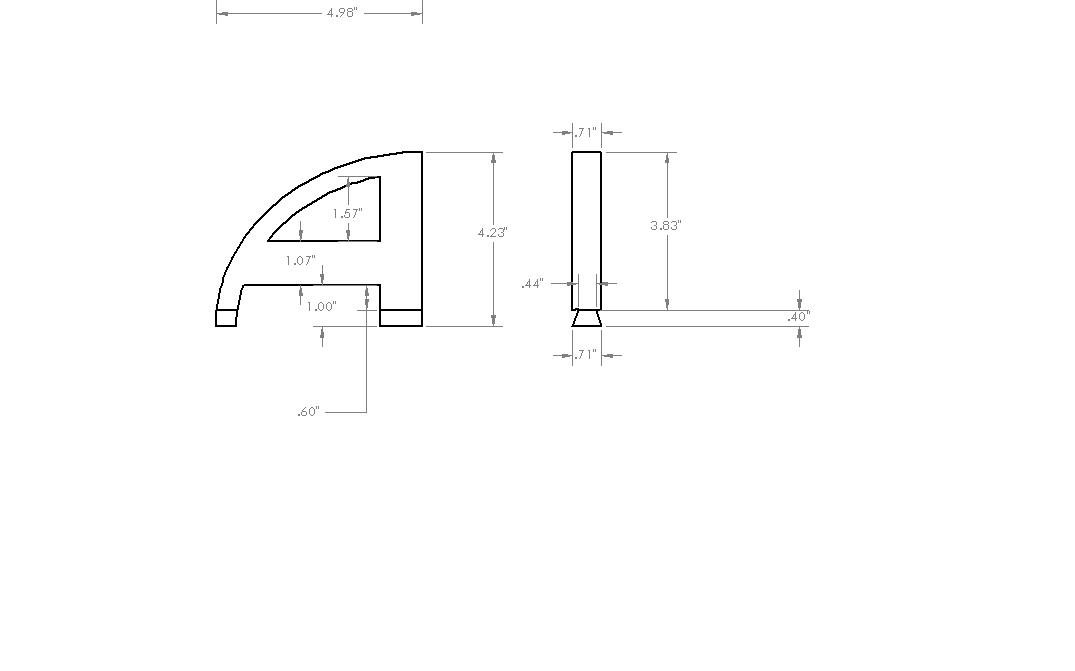
img/shuyen/ver1/support leg.JPG
