tel/4601/img/shuyen/ver1/top fame.JPG

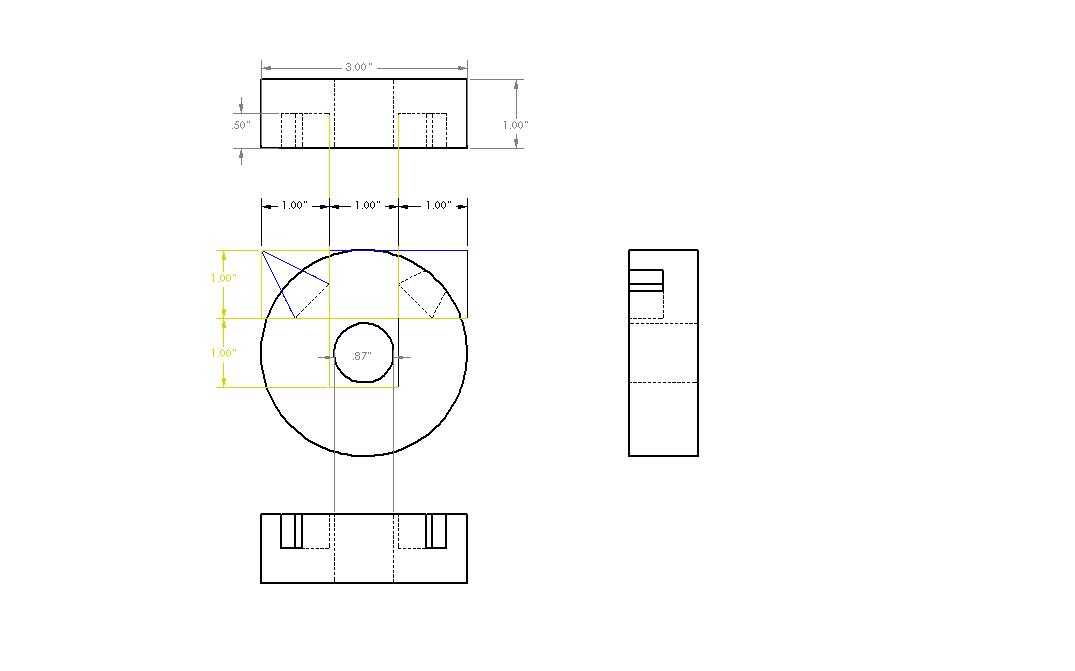
img/shuyen/ver1/top fame.JPG
