tel/4601/img/shuyen/ver1/top_down frame1.JPG

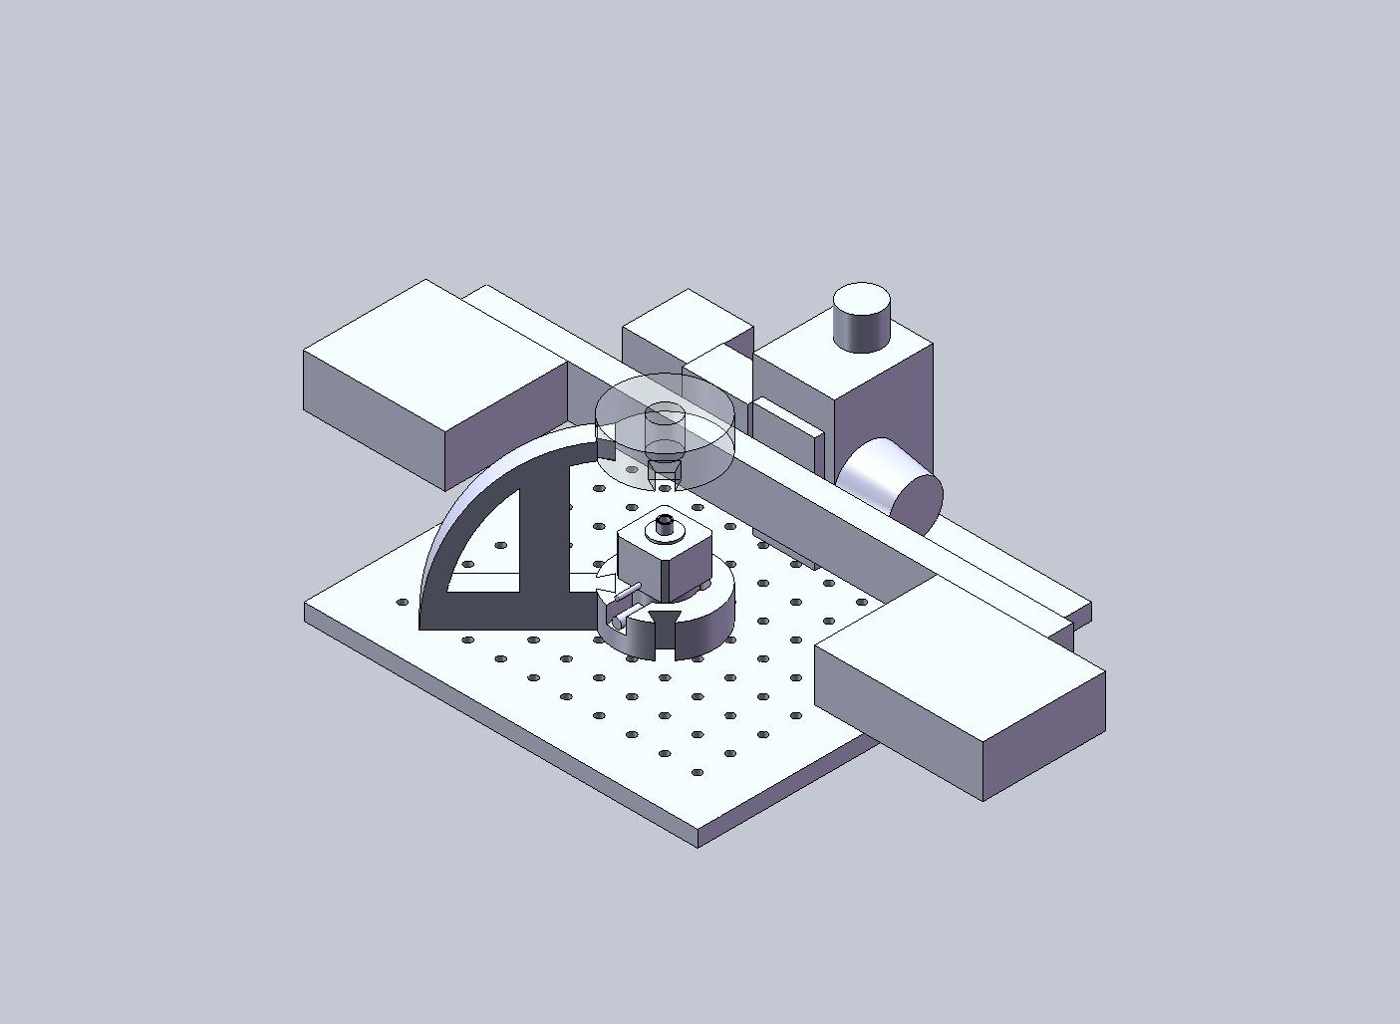
img/shuyen/ver1/top_down frame1.JPG
