tel/4601/img/shuyen/ver1/top_down frame3front.JPG

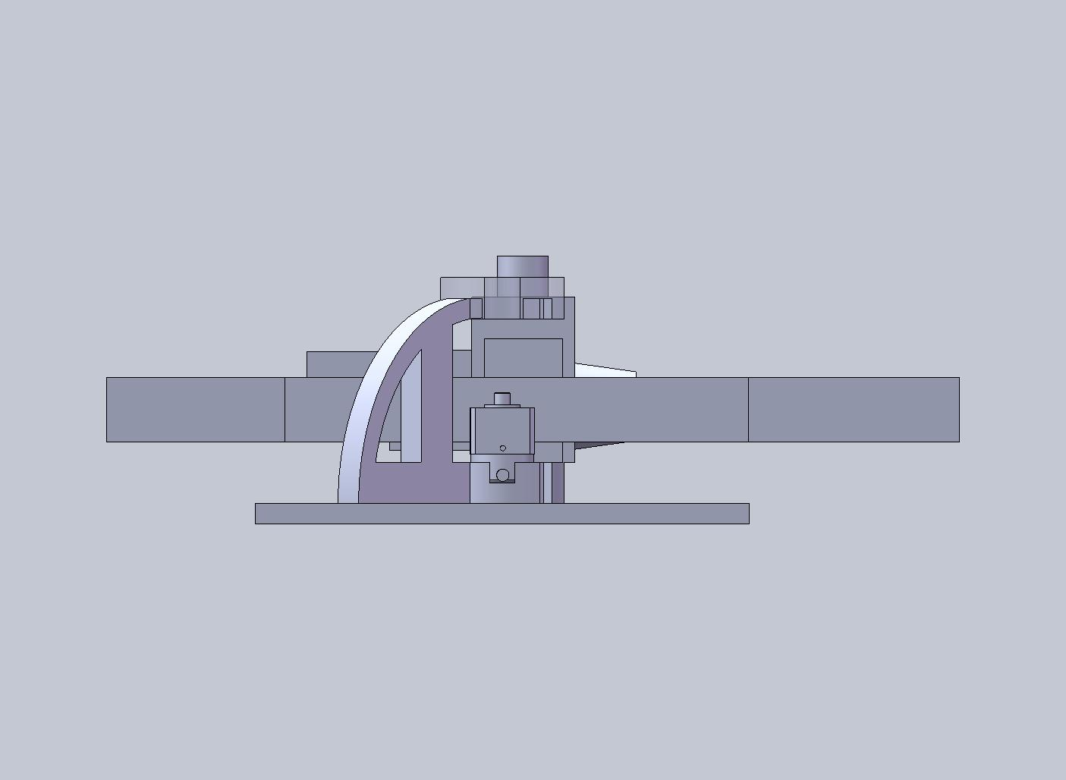
img/shuyen/ver1/top_down frame3front.JPG
