tel/4601/img/shuyen/ver1/top_down frame4top.JPG

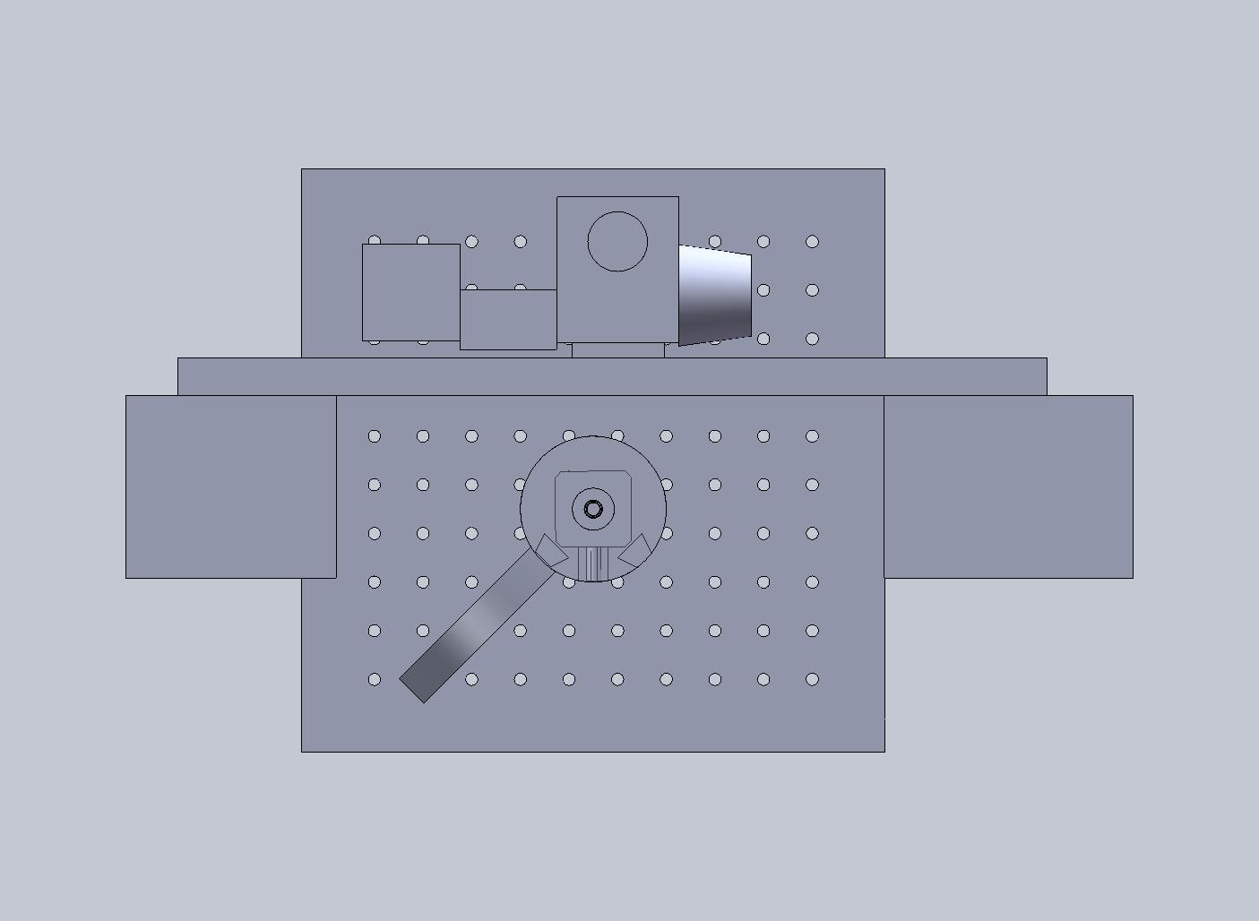
img/shuyen/ver1/top_down frame4top.JPG
