tel/4601/img/shuyen/ver1/top_down frame5side.JPG

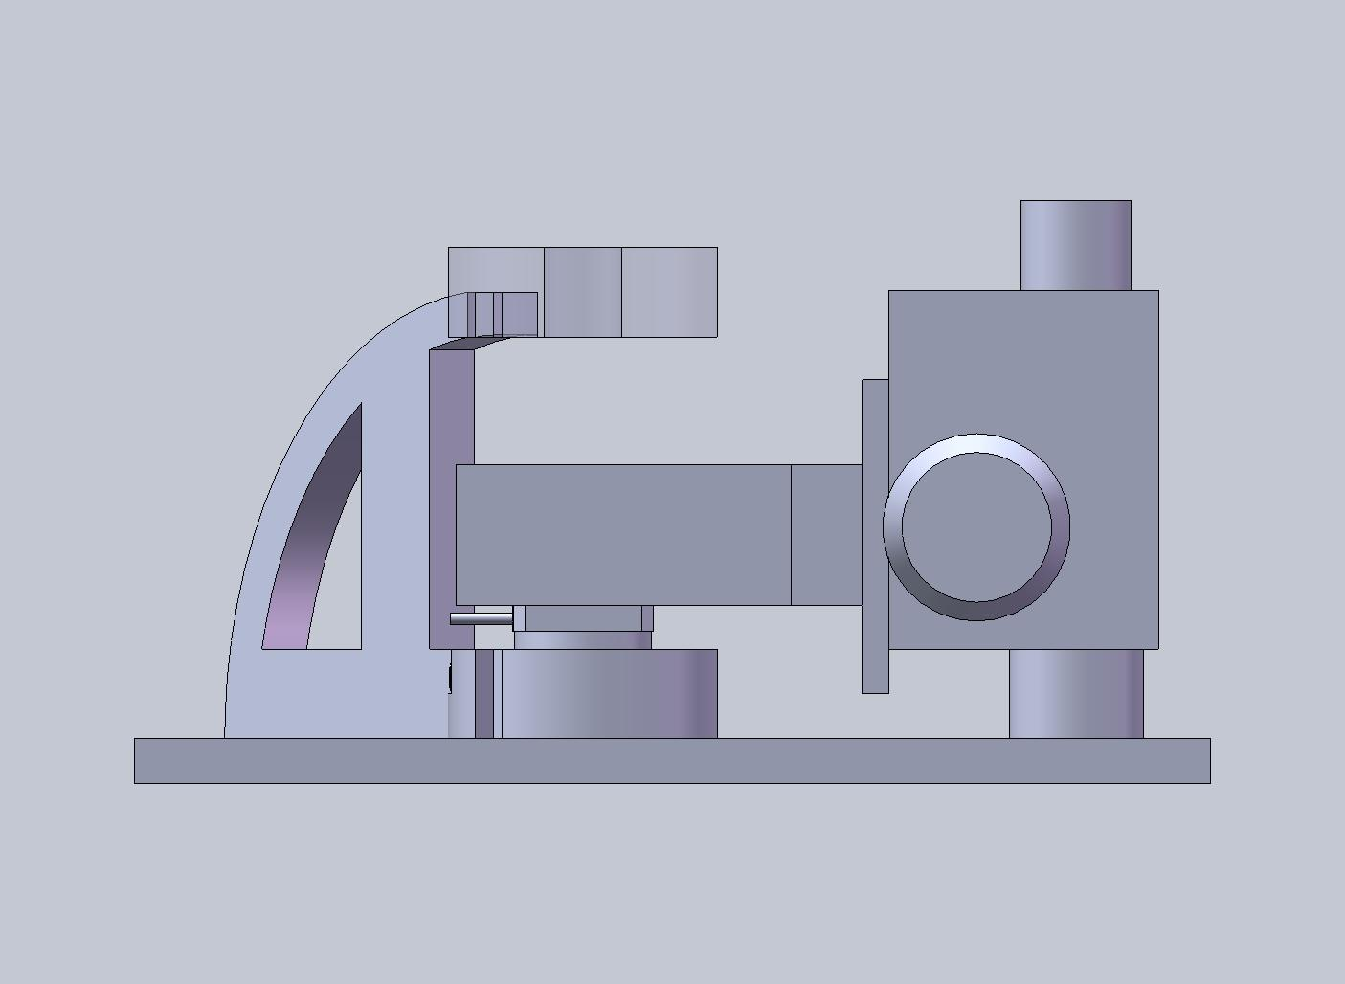
img/shuyen/ver1/top_down frame5side.JPG
