tel/4601/img/shuyen/ver1/top_down frame exploded.JPG

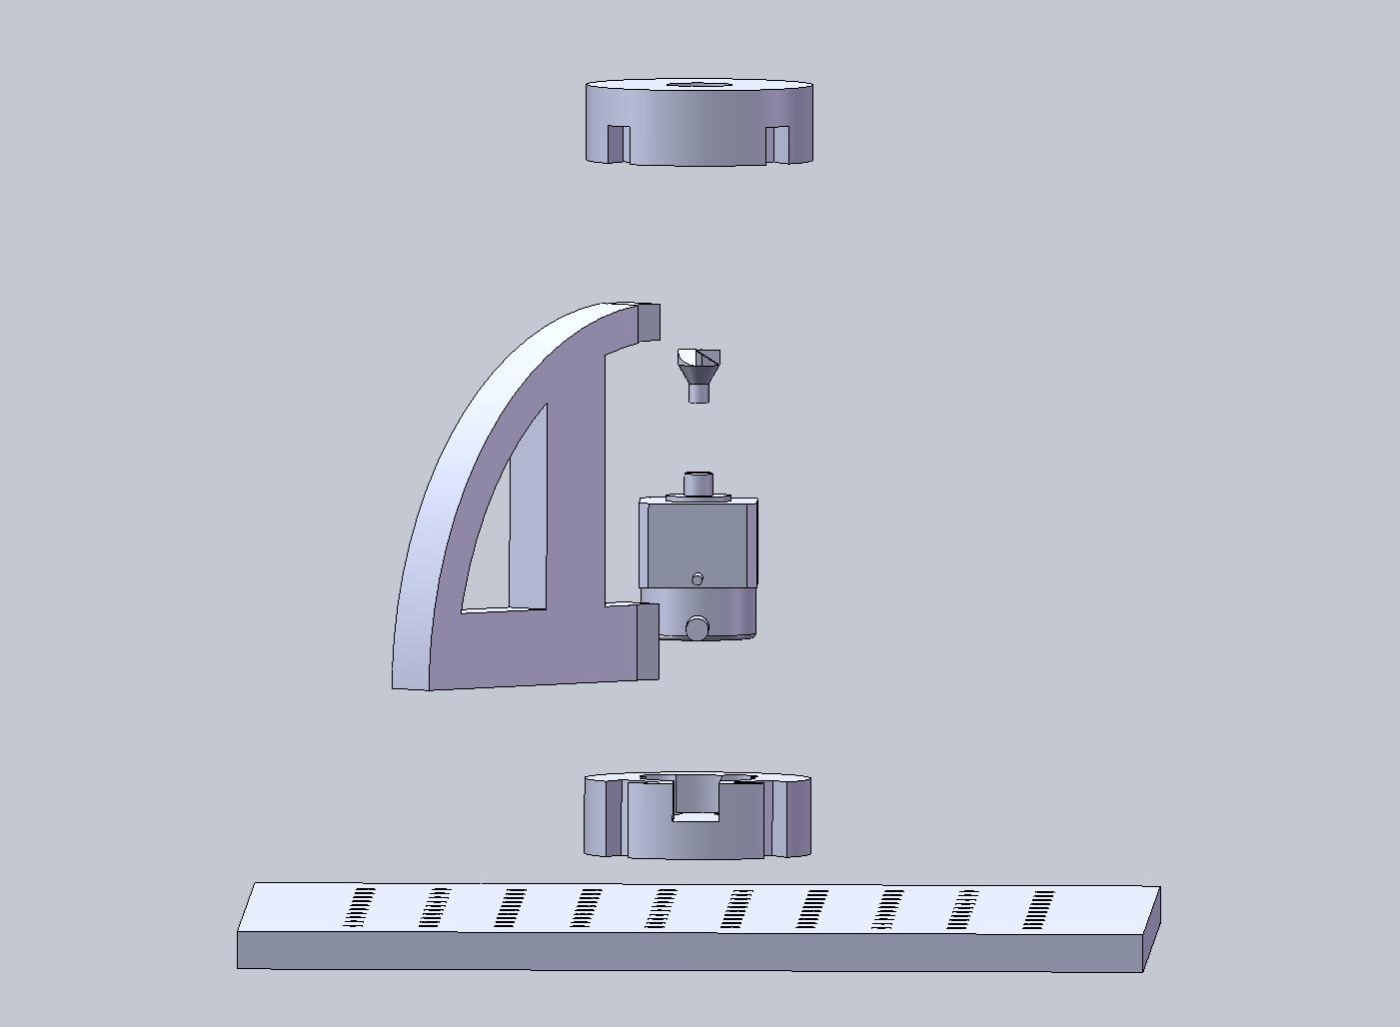
img/shuyen/ver1/top_down frame exploded.JPG
