tel/4601/img/shuyen/ver final/bottom cap.JPG

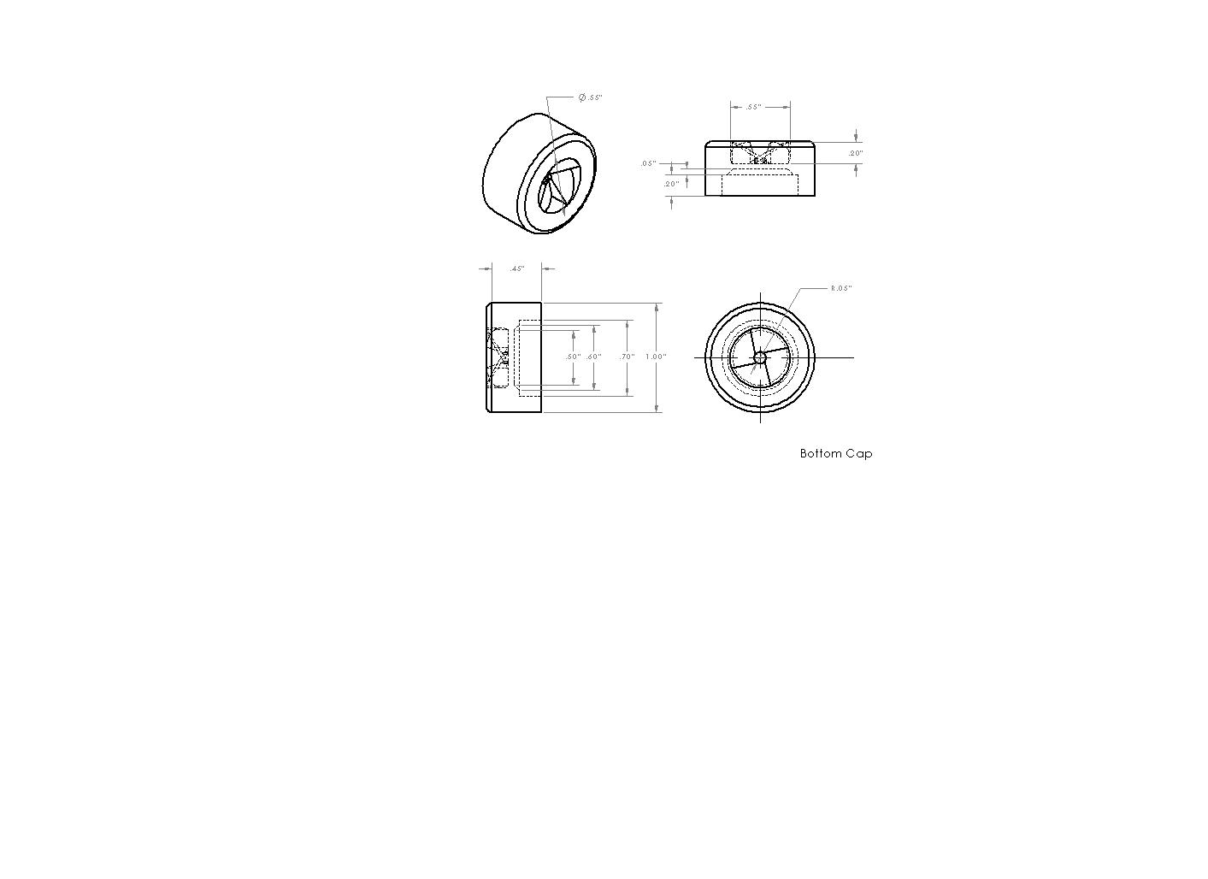
img/shuyen/ver final/bottom cap.JPG
