tel/4601/img/shuyen/ver final/bottom frame.JPG

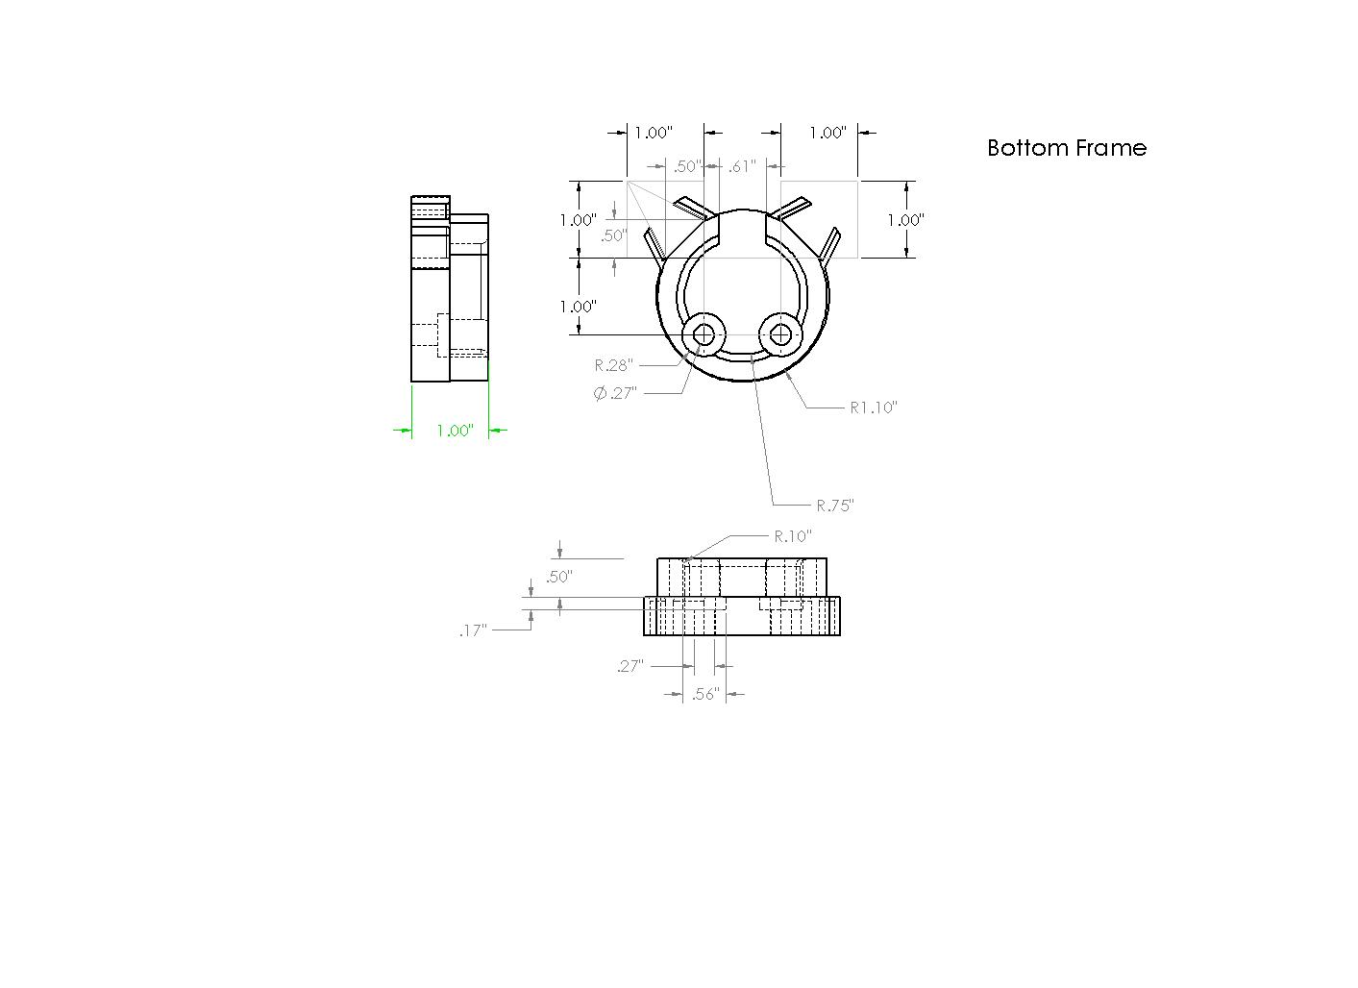
img/shuyen/ver final/bottom frame.JPG
