tel/4601/img/shuyen/ver final/support leg.JPG

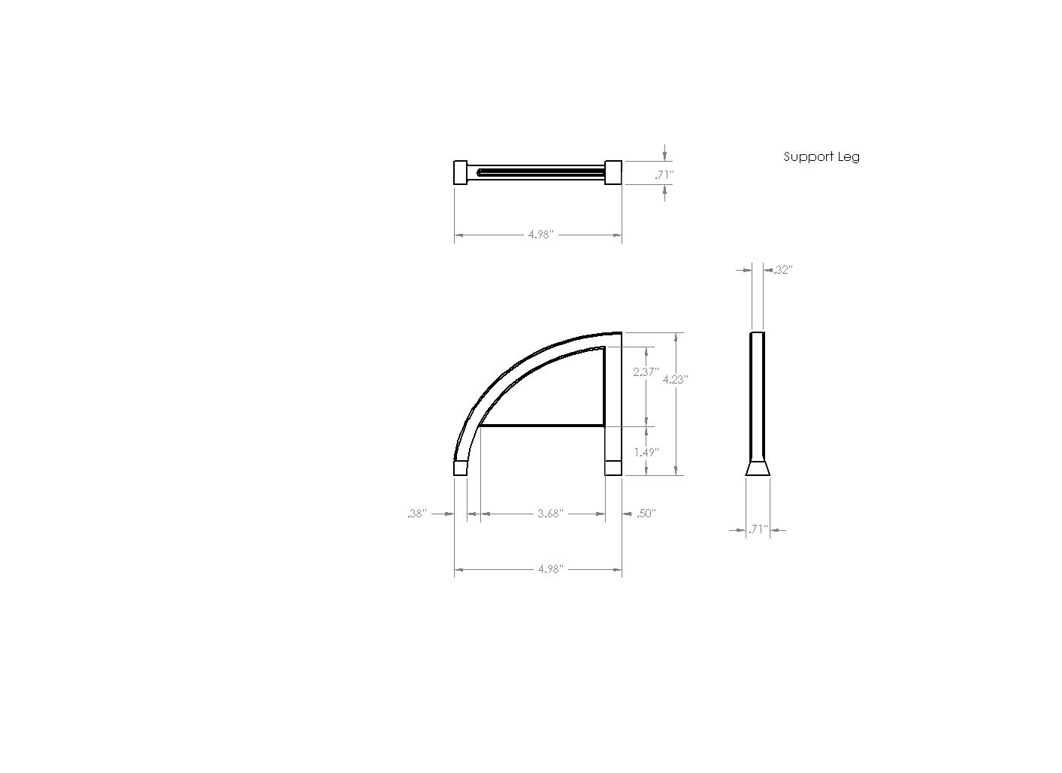
img/shuyen/ver final/support leg.JPG
