tel/4601/img/shuyen/ver final/syr_mic_connector.JPG

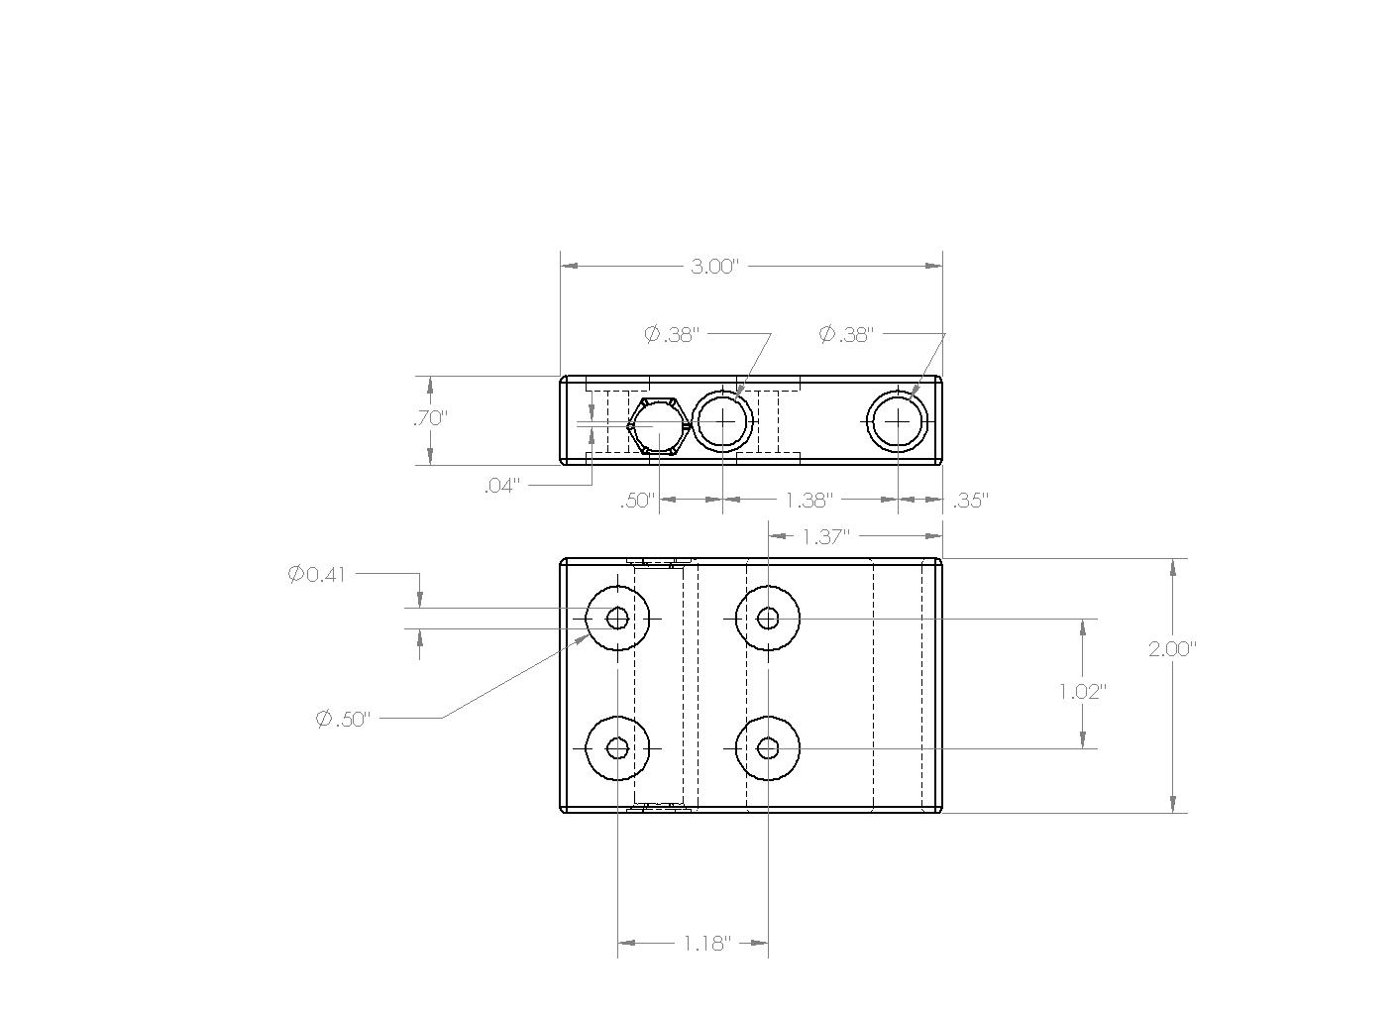
img/shuyen/ver final/syr_mic_connector.JPG
