tel/4601/img/shuyen/ver final/top cap.JPG

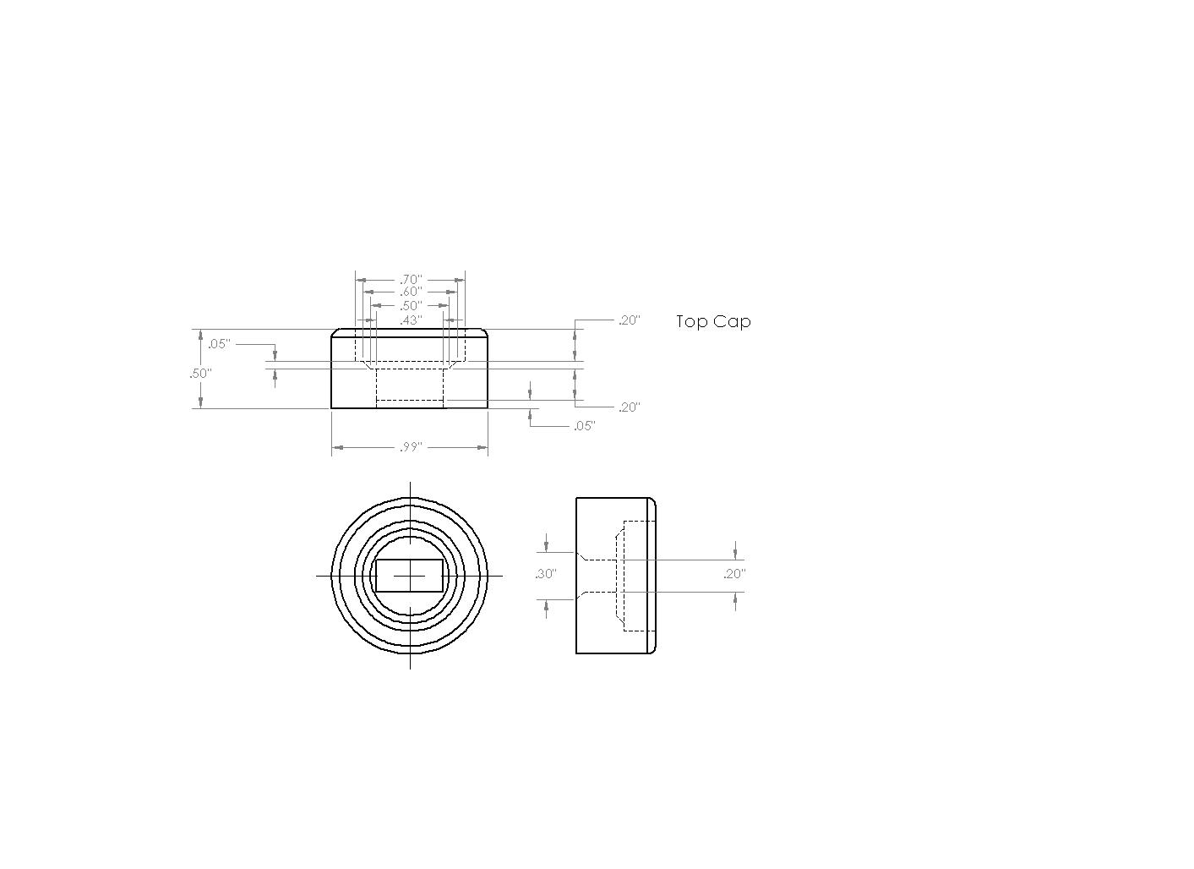
img/shuyen/ver final/top cap.JPG
