tel/4601/img/shuyen/ver final/top fame.JPG

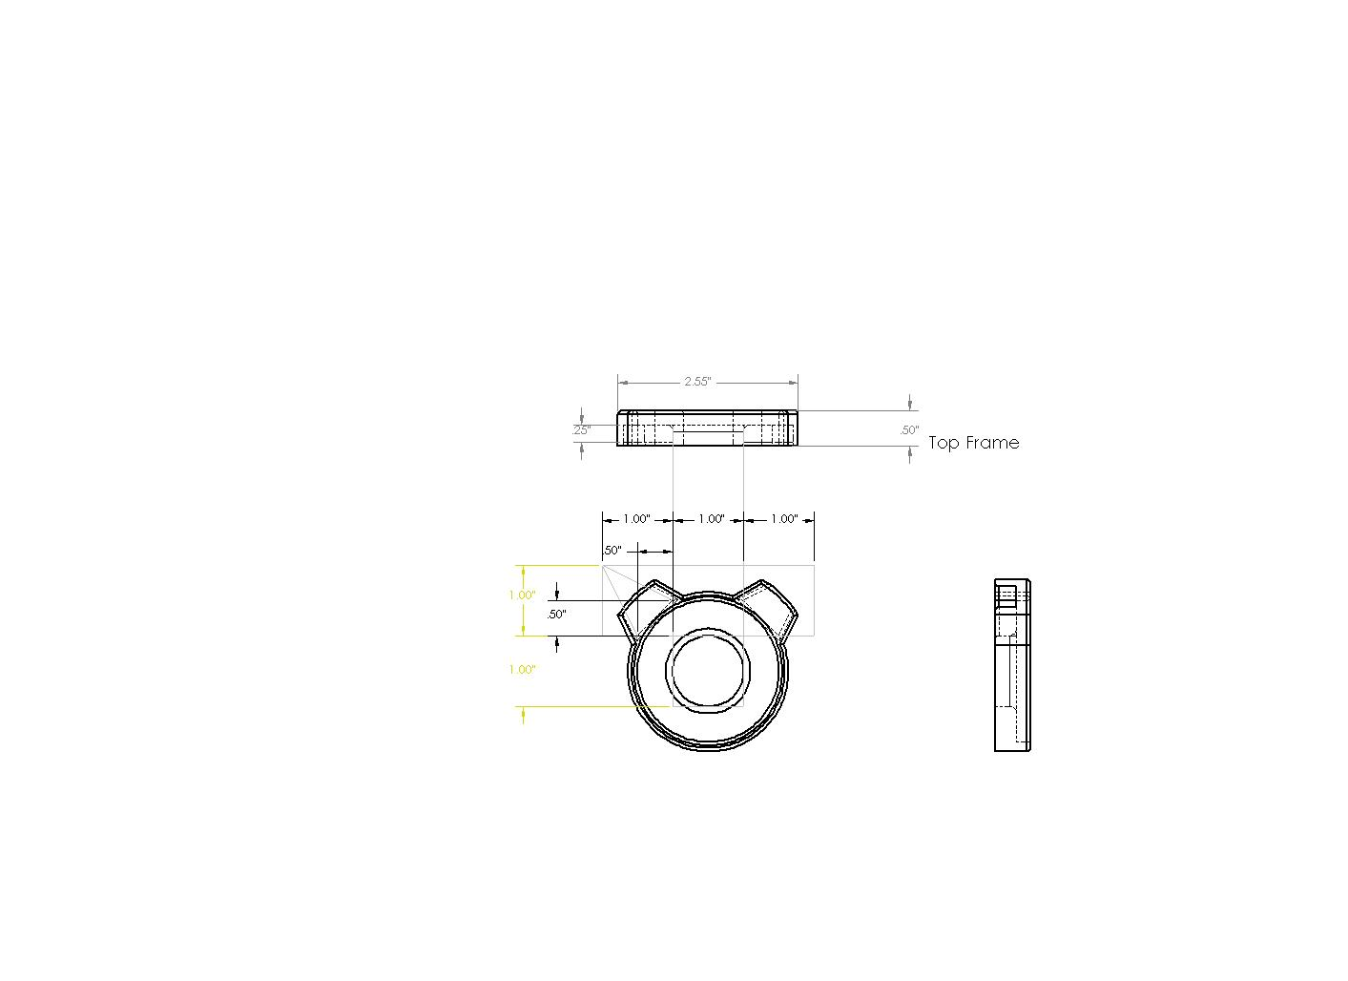
img/shuyen/ver final/top fame.JPG
