tel/4601/img/shuyen/ver final/top_down frame exploded.JPG

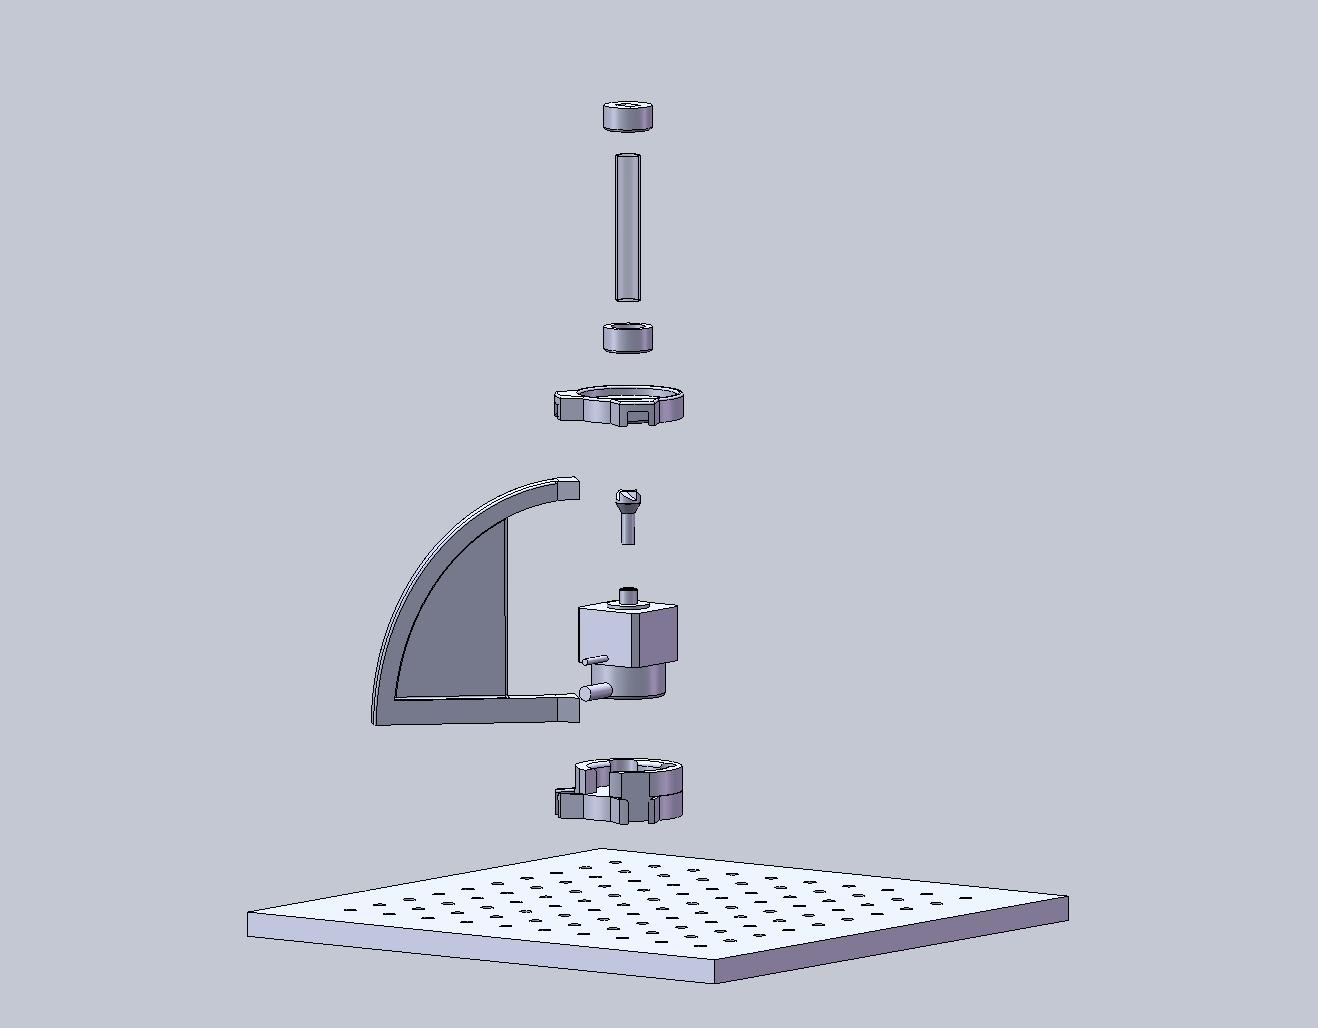
img/shuyen/ver final/top_down frame exploded.JPG
