tel/4601/img/shuyen/ver final/top_down frame.SLDASM

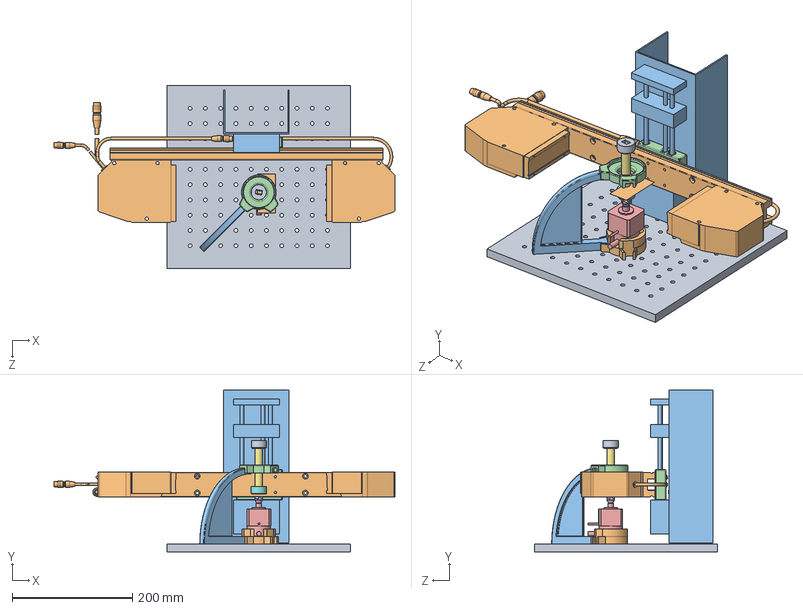
[picture p28: CAD file, 2010-04-20]
img/shuyen/ver final/top_down frame.SLDASM
567.4 x 269.1 x 304.8 mm
base
bottom frame
support leg
top fame
motor_endcoder
testtube connector
testtube
bottom cap
top cap
LS-7070M
syringep pump
syr_mic_connector
