tel/4601/img/shuyen/ver final/testtube connector.JPG

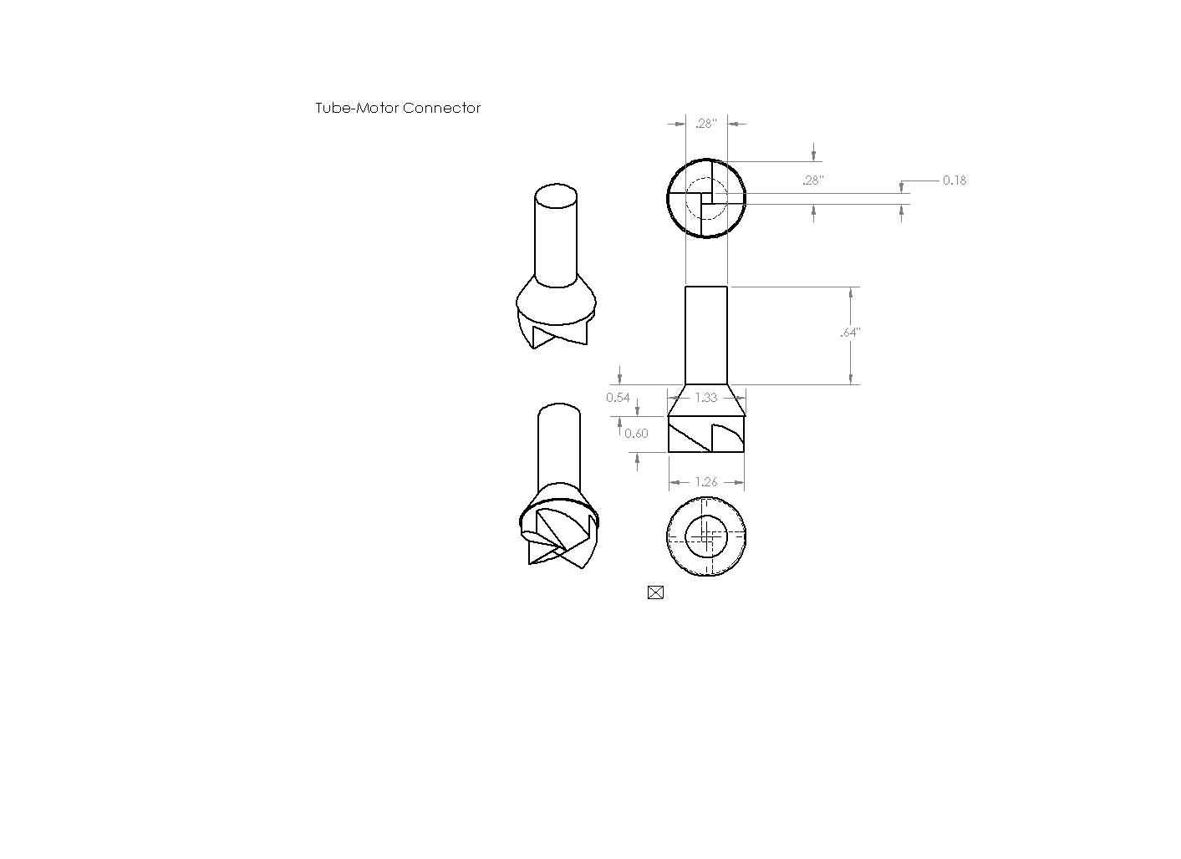
img/shuyen/ver final/testtube connector.JPG
