tel/4601/(commit log)

2010-01-26 Added usage flowchart figure and reference in project description.
2010-01-26 Added Shuyen's solidedge rendering figures.
    All figures currently align to their own figure page. Not totally sure how to work this, we'll have to play and find out the best method.
2010-01-26 Added spring_gantt.png Gantt Chart for the spring semester along with document reference.
2010-01-26 cut down EDS even more
2010-02-02 Edited wording to make it more clear that myopia is a proximal symptom, but current research is interested in the underlying genetic effects on development of the eye.
2010-02-02 * update/grade.org: New TODO -> create a better schematic/isometric view
2010-02-08 Added an intro, still need exec summary and conclusion, and an economic impact section which we don't have. Currently editing other subsections
2010-02-08 * sia/sia.tex: Updated technical description of the device.
2010-02-22 Edited fluid inside tube test
2010-03-14 Skeleton entry for regulatory report
2010-03-15 * regulatory/reg.tex: Moved the emacs temp variables to the end where they belong
2010-03-15 * regulatory/pages/cover.tex: Fixed Emacs AucTeX variables
2010-03-15 * regulatory/reg.tex: Removed ugly "510(k) Premarket Notification" section header in document.
    Retained this in the TOC. It definitely exists, just doesn't need its own section header
2010-03-15 * regulatory/pages/indications.tex: Added that dumb postabmle to the Indications pages
2010-03-15 * regulatory/pages/elec.tex: EC -> IEC
2010-03-15 * regulatory/pages/certification.tex: Removed an 'I'
2010-03-15 * regulatory/reg.tex: IT WORKS!
2010-03-15 * regulatory/reg.tex: REALLY WORKS!
2010-03-15 * regulatory/reg.tex: Changes Shuyen's section to properly use the Enumerate environment
2010-03-15 Finished regulatory overview. Sorry I messed up the spacing.
2010-03-16 fixed device classification and regulations sections
2010-03-16 * regulatory/reg.tex: Beginnings of the Device Description
2010-03-16 * regulatory/pages/cdrh-pics/5.png: Like this -----
2010-03-16 * regulatory/reg.tex: META-Q BITCH
2010-03-16 * regulatory/reg.tex: Software section
2010-03-16 * regulatory/reg.tex: Fixed Sanjay's dumb fake table
2010-03-16 * regulatory/reg.tex: Added table comments to sanjay's lame table
2010-04-13 Some prototype development stuff, need software, optics, and fixate solution parts
2010-04-19 Edited Project Desc and EDS, added subsections, now to prototype + testing, also need to make addendums
2010-04-19 edited part of prototype. still editing.
2010-04-19 prototype done except for image reconstruction/electronic/Sanjay's
2010-04-20 images that we might be able to use
    [top_down frame.SLDASM]
